pacovalverde/nerdquaxe/case/grill-part2.stl

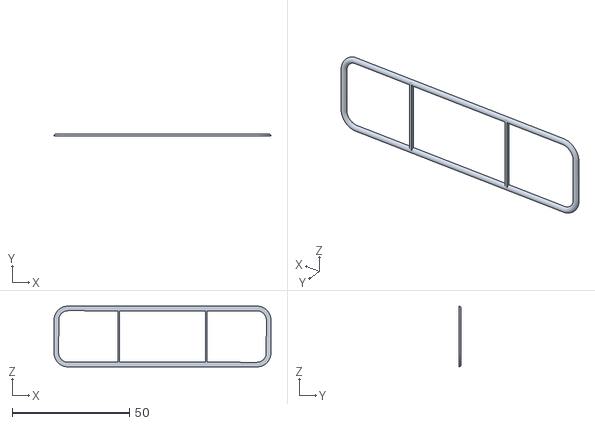
[picture p1: CAD file, 2025-05-31]
case/grill-part2.stl
92.7 x 1.00 x 26.0
