pacovalverde/nerdquaxe/nerdqaxe++/nerdqaxe++/3d/heatsink-13x12x5.step

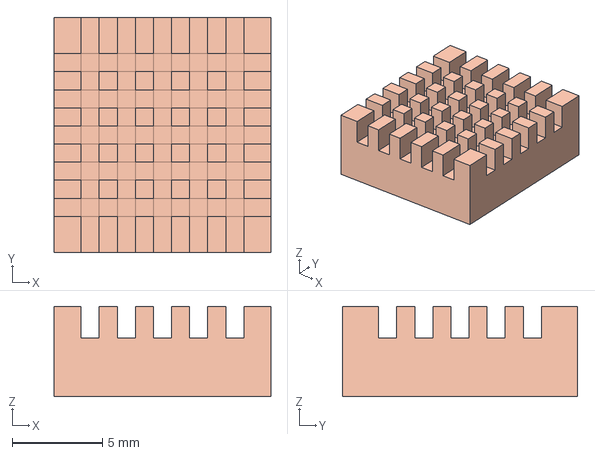
[picture p2: CAD file, 2025-05-31]
nerdqaxe++/nerdqaxe++/3d/heatsink-13x12x5.step
12.0 x 13.0 x 5.00 mm
