pacovalverde/nerdquaxe/nerdqaxe+/nerdqaxe+/3d/bm1366.step

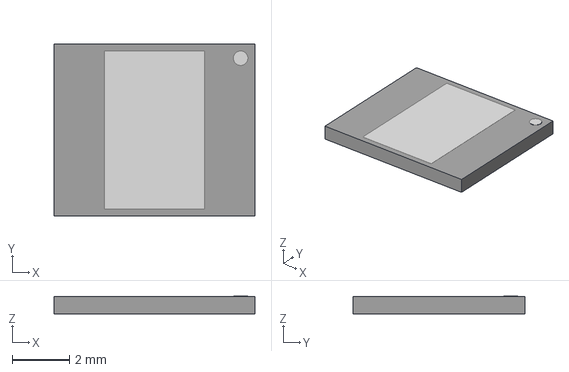
[picture p3: CAD file, 2025-05-31]
nerdqaxe+/nerdqaxe+/3d/bm1366.step
7.00 x 6.00 x 0.61 mm
