pacovalverde/nerdquaxe/case/case.stl

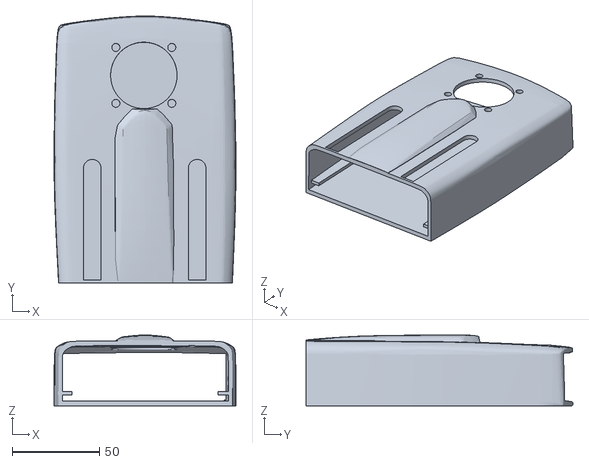
[picture p5: CAD file, 2025-05-31]
case/case.stl
104.1 x 152.7 x 40.6
