pacovalverde/nerdquaxe/qaxe+/qaxe/3d/lga115x.step

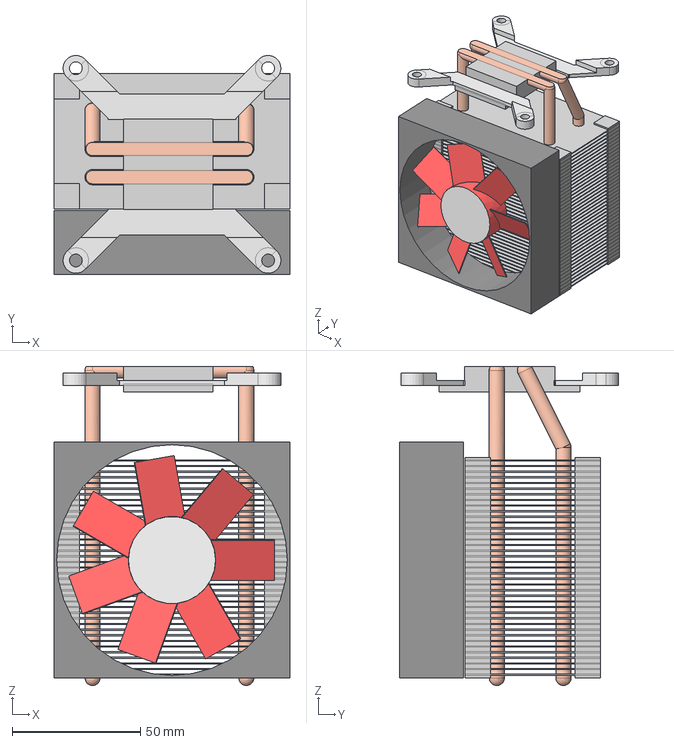
[picture p6: CAD file, 2025-05-31]
qaxe+/qaxe/3d/lga115x.step
92.0 x 85.5 x 124.5 mm
