pacovalverde/nerdquaxe/case/grill-part1.stl

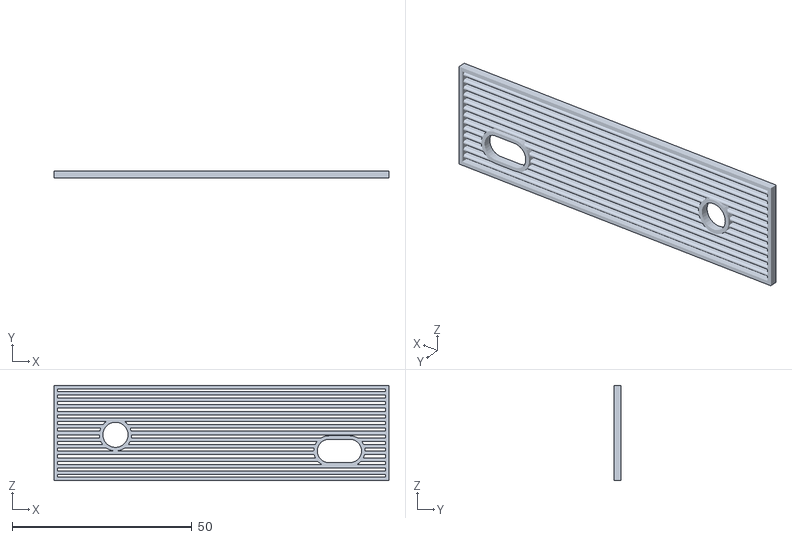
[picture p8: CAD file, 2025-05-31]
case/grill-part1.stl
93.2 x 2.00 x 26.5
