pacovalverde/nerdquaxe/nerdqaxe++/nerdqaxe++/3d/bm1370.step

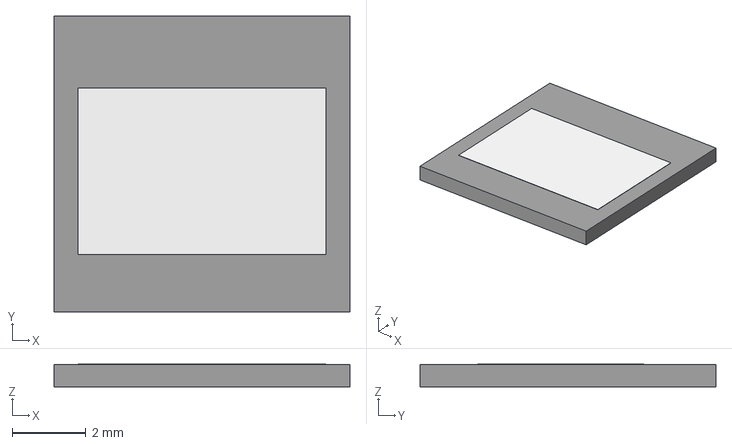
[picture p9: CAD file, 2025-05-31]
nerdqaxe++/nerdqaxe++/3d/bm1370.step
8.00 x 8.00 x 0.61 mm
