pacovalverde/nerdquaxe/qaxe/qaxe/3d/barrel-jack.step

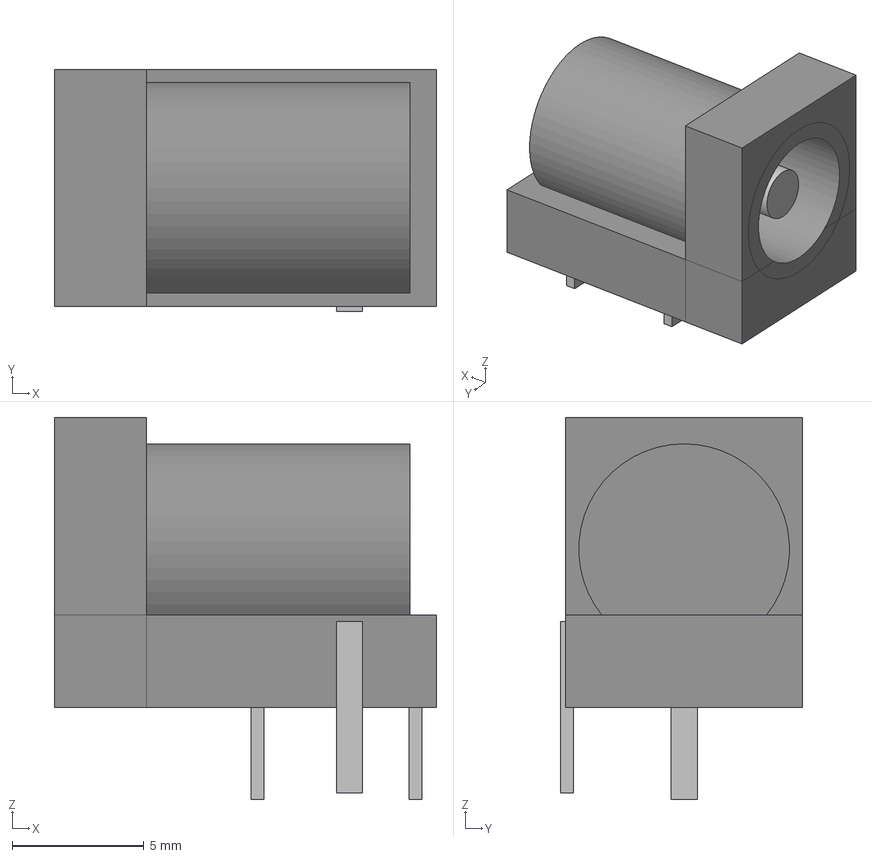
[picture p10: CAD file, 2025-05-31]
qaxe/qaxe/3d/barrel-jack.step
14.5 x 9.20 x 14.5 mm
