pacovalverde/nerdquaxe/case/back.stl

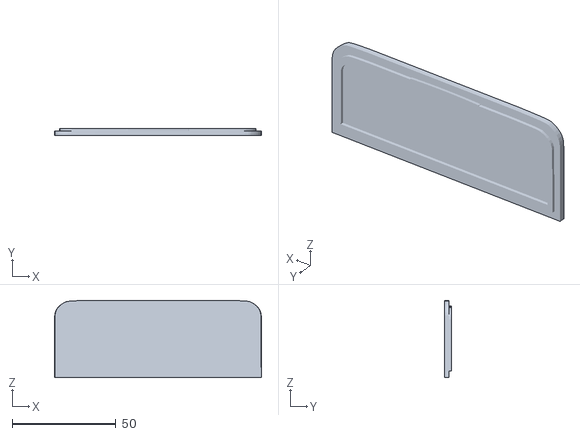
[picture p11: CAD file, 2025-05-31]
case/back.stl
99.7 x 3.54 x 37.3
