pacovalverde/nerdquaxe/nerdqaxe++/nerdqaxe++/3d/DCJ250-20-B-XX-X_REVA1.step

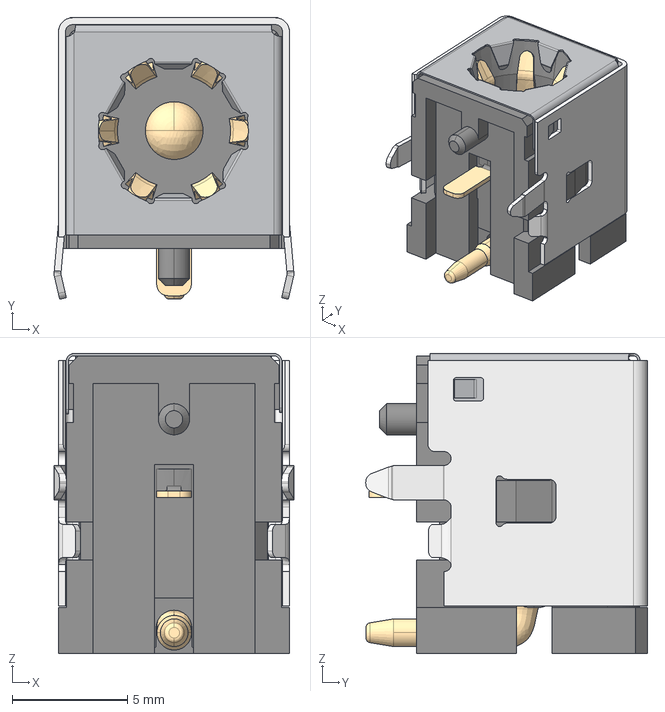
[picture p12: CAD file, 2025-05-31]
nerdqaxe++/nerdqaxe++/3d/DCJ250-20-B-XX-X_REVA1.step
10.4 x 12.2 x 13.0 mm
