pacovalverde/nerdquaxe/nerdqaxe+/nerdqaxe+/3d/KMR231GLFS.stp

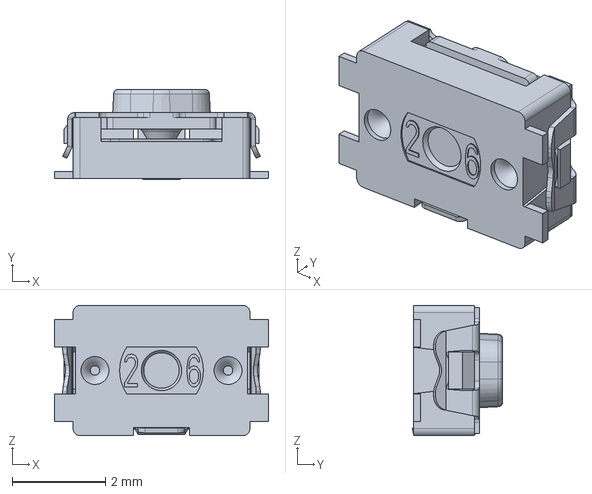
[picture p13: CAD file, 2025-05-31]
nerdqaxe+/nerdqaxe+/3d/KMR231GLFS.stp
4.60 x 1.94 x 2.80 mm
