pacovalverde/nerdquaxe/nerdqaxe+/nerdqaxe+/3d/T-Display-S3.STEP

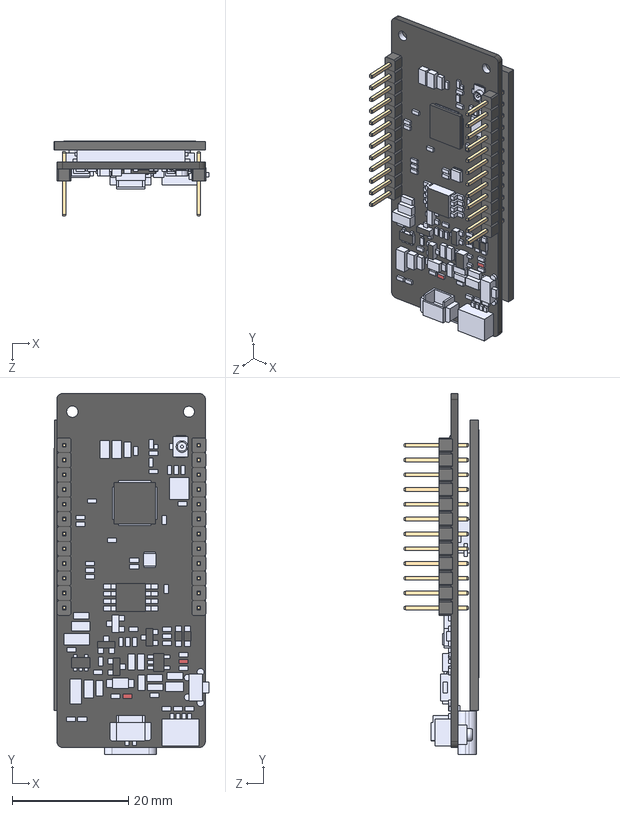
[picture p14: CAD file, 2025-05-31]
nerdqaxe+/nerdqaxe+/3d/T-Display-S3.STEP
26.5 x 62.0 x 12.9 mm
MainBoard_3D
Ecran
1_Male_Pin_2.54_mm x 24
