pacovalverde/nerdquaxe/(list of files, cad)

Other CAD files:
nerdqaxe++/nerdqaxe++/3d/bm1370.scad
nerdqaxe++/nerdqaxe++/3d/csd95472.scad
nerdqaxe++/nerdqaxe++/3d/csg95472.step
