pacovalverde/nerdquaxe/qaxe/qaxe/qaxe.kicad_pcb

## KiCad design qaxe/qaxe/qaxe.kicad_pcb (2025-05-31)

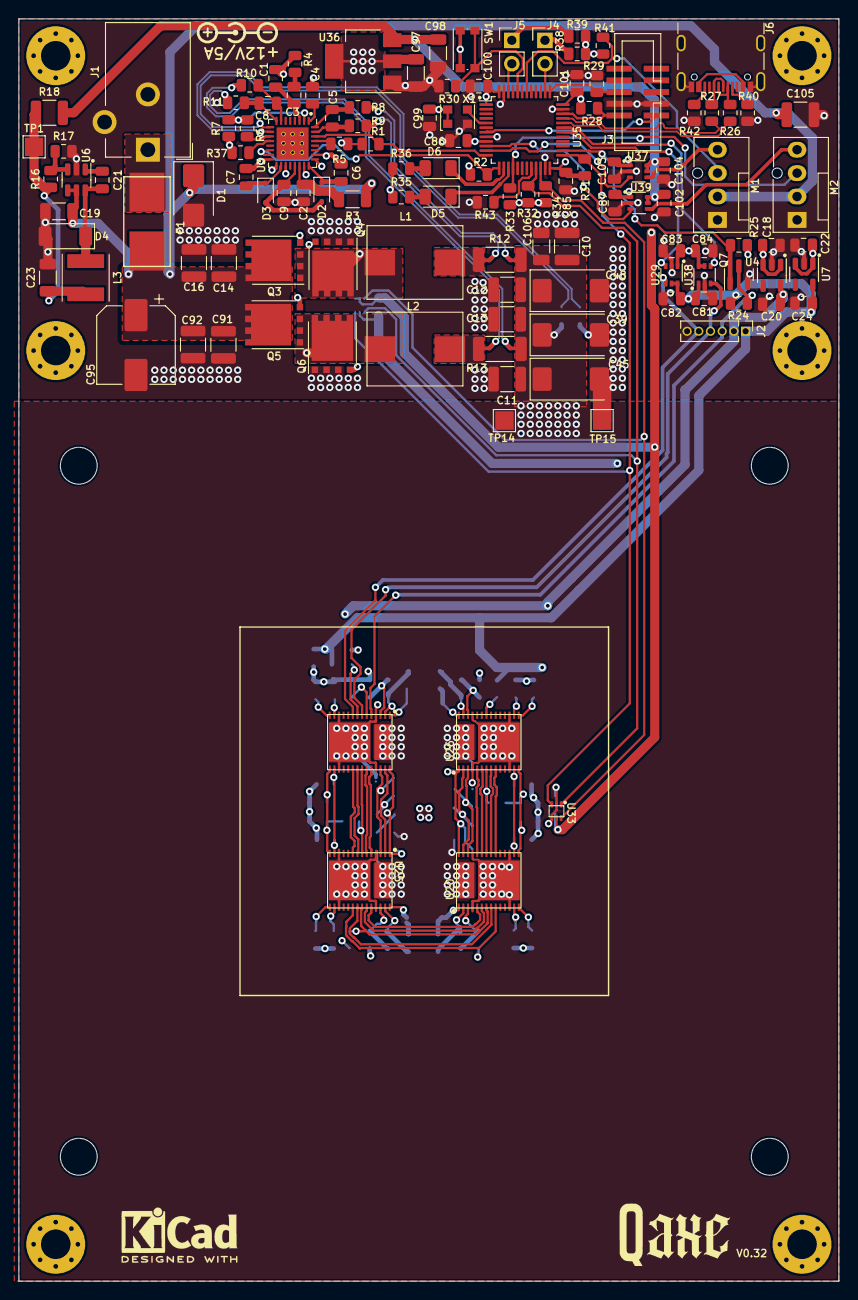
[picture p15: board qaxe.kicad_pcb from above]

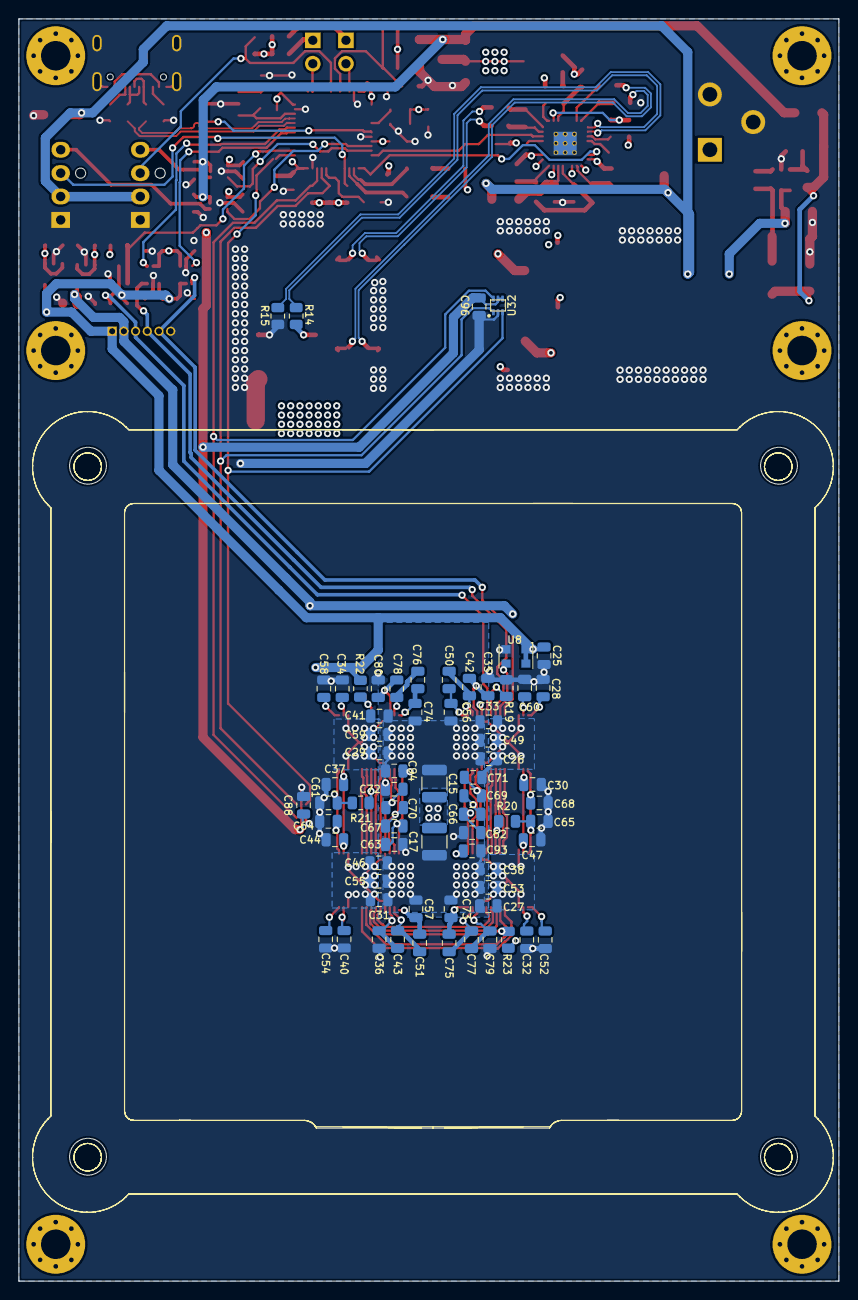
[picture p16: board qaxe.kicad_pcb from below]

Board: 4 copper layers, 89.0 x 137.0 mm, 198 parts (68 on the bottom side), 115 nets.

Parts:
C1: 47p; C_0805_2012Metric
C2, C4, C6, C7, C18, C22, C25, C49, C53, C55, C59, C81, C82, C83, C84, C85, C86, C87, C88, C96, C99, C100, C101, C102, C103, C104: 100n; C_0805_2012Metric
C3: 3.3n; C_0805_2012Metric
C5, C8: 1n; C_0805_2012Metric
C9: 4.7µ/25V; C_0805_2012Metric
C10, C11, C12, C13, C15, C17: 100µ/6.3V; C_1210_3225Metric
C14, C16, C91, C92, C105: 22µ/25V; C_1210_3225Metric
C19, C98: 10µF/50V; C_1206_3216Metric
C20, C24, C28, C30, C32, C33, C34, C35, C36, C37, C38, C40, C41, C42, C43, C44, C46, C47, C50, C51, C52, C54, C56, C57, C58, C60, C61, C62, C63, C64, C65, C66, C67, C68, C69, C70, C71, C72, C73, C74, C75, C76, C77, C78, C79, C80, C93, C94: 1µ; C_0805_2012Metric
C21: 10n/250V; C_0805_2012Metric
C23, C97: 22µ/16V; C_1206_3216Metric
C26, C27, C29, C31: 10µ/16V; C_0805_2012Metric
C39, C45, C48: 330µ/6.3V; CP_EIA-7343-15_Kemet-W
C95: 220µ/25V; CP_Elec_8x10
C106: 4.7µ/6.3V; C_1206_3216Metric
D1: SMBJ12A; D_SMB
D2, D3: CMDSH-3; D_SOD-323
D4: PMEG4030EP,115; D_SOD-128
D5, D6: LED; LED_1206_3216Metric
F1: 5A; fuseholder_littlefuse_blok
J1: Barrel_Jack_Switch; BarrelJack_CUI_PJ-102AH_Horizontal
J2: Conn_01x06; PinHeader_1x06_P1.27mm_Vertical
J3: SWD; PinHeader_IDC_2x05_P1.27mm_Vertical_SMD
J4, J5: Conn_01x02; PinHeader_1x02_P2.54mm_Vertical
J6: USB_C_Receptacle_USB2.0; USB_C_Receptacle_GCT_USB4105-xx-A_16P_TopMnt_Horizontal
L1, L2: 220nH; IFLR-4031GC-01-8x10
L3: 4.7µH/2A/3A; L_Taiyo-Yuden_NR-50xx
M1, M2: Fan_4pin; FanPinHeader_1x04_P2.54mm_Vertical
NT1, NT2, NT3, NT4: NetTie_2; NetTie-2_SMD_Pad0.5mm
NT7: NetTie_2; NetTie-2_L3_SMD_Pad0.5mm
Q3, Q4, Q5, Q6: CSD16415Q5T; VSONP-8-1EP_5x6_P1.27mm
Q7: BSS138; SOT-23
R1, R19, R20, R21, R22, R23, R24, R25, R28, R29, R31, R43: 10k; R_0805_2012Metric
R2, R32, R34: 1.5k; R_0805_2012Metric
R3: 2.2R; R_1206_3216Metric
R4: 8.45k; R_0805_2012Metric
R5, R30: 100k; R_0805_2012Metric
R6: 22k; R_0805_2012Metric
R7: 20k; R_0805_2012Metric
R8, R9, R10, R11: 200; R_0805_2012Metric
R12, R13: 1mR; R_2010_5025Metric
R14, R15: 10; R_0805_2012Metric
R16: 84.5k; R_0805_2012Metric
R17: 16.3k; R_0805_2012Metric
R18: 0; R_1210_3225Metric
R26, R27: 22; R_0805_2012Metric
R33, R41: 2.7k; R_0805_2012Metric
R35, R36, R38, R39: 560; R_0805_2012Metric
R37: 49.9k; R_0805_2012Metric
R40, R42: 5.1k; R_0805_2012Metric
SW1: boot; SW_Push_1P1T_NO_CK_KMR2
TP1, TP14, TP15: 3V3; TestPoint_Pad_2.0x2.0mm
U1: polarity
U3: LTC3856; QFN-32-1EP_5x5mm_P0.5mm_EP3.45x3.45mm_ThermalVias
U4: MCP1824T-0802E; SOT-23-5
U6: AP3211; SOT-23-6
U7: MCP1824T-1802E; SOT-23-5
U8: 25MHz; Oscillator_SMD_EuroQuartz_XO32-4Pin_3.2x2.5mm
U19, U20, U25, U26: BM1366_mode1; BM1366
U29, U37, U38, U39: TXU0101; SOT-363_SC-70-6
U32, U33: TMP1075; TMP1075-DRL
U35: STM32L072CBT6; LQFP-48_7x7mm_P0.5mm
U36: 1117-3.3; SOT-223-3_TabPin2
X1: 8MHz; Oscillator_SMD_EuroQuartz_XO32-4Pin_3.2x2.5mm

Connections:
+0V8: C20.1, C28.2, C30.2, C32.2, C34.2, C37.2, C40.2, C44.2, C47.2, J2.2, U4.5 (VOUT), U19.13 (VDDIO_08_0), U19.16 (VDDIO_08_1), U20.13 (VDDIO_08_0), U20.16 (VDDIO_08_1), U25.13 (VDDIO_08_0), U25.16 (VDDIO_08_1), U26.13 (VDDIO_08_0), U26.16 (VDDIO_08_1)
+1V2: C10.1, C11.1, C12.1, C13.1, C15.1, C17.1, C26.1, C27.1, C29.1, C31.1, C33.1, C38.1, C39.1, C41.1, C45.1, C46.1, C48.1, C49.1, C53.1, C55.1, C56.2, C57.2, C59.1, C62.1, C63.1, C73.1, C74.1, C93.2, C94.2, C106.1, NT3.1, NT4.2, R12.2, R13.2, R14.1, TP14.1, U19.29 (VDD), U20.29 (VDD), U25.29 (VDD), U26.29 (VDD)
+1V8: C24.1, C25.1, C52.1, C54.1, C58.1, C60.1, C61.1, C64.1, C65.1, C68.1, C81.1, C82.1, J2.1, R20.2, R21.2, R22.2, R23.2, R24.2, U7.5 (VOUT), U8.1 (Standby), U8.4 (VDD), U19.14 (VDDIO_18_0), U19.15 (VDDIO_18_1), U20.14 (VDDIO_18_0), U20.15 (VDDIO_18_1), U25.14 (VDDIO_18_0), U25.15 (VDDIO_18_1), U26.14 (VDDIO_18_0), U26.15 (VDDIO_18_1), U29.5 (OE), U29.6 (VCCB), U38.1 (VCCA)
+3V3: C18.1, C22.1, C83.1, C84.1, C85.1, C86.1, C87.1, C88.1, C96.1, C97.1, C99.1, C100.1, C101.1, C103.1, R2.1, R25.2, R28.2, R31.1, R32.1, R33.1, R34.1, R35.1, R36.1, R38.1, R39.1, R41.1, SW1.2, U4.1 (VIN), U4.3 (EN), U7.1 (VIN), U7.3 (EN), U29.1 (VCCA), U32.4 (A0), U32.5 (V+), U33.5 (V+), U35.1 (VLCD), U35.9 (VDDA), U35.24 (VDD), U35.36 (VDD), U35.48 (VDD), U36.2 (VO), U37.1 (VCCA), U38.5 (OE), U38.6 (VCCB), U39.1 (VCCA), X1.1 (EN), X1.4 (V+)
+5V: C98.1, C102.1, C104.1, R18.2, U36.3 (VI), U37.5 (OE), U37.6 (VCCB), U39.5 (OE), U39.6 (VCCB)
+12V: C14.1, C16.1, C19.1, C91.1, C92.1, C95.1, C105.1, D1.1 (A1), F1.1, M1.2 (+), M2.2 (+), Q3.3 (D), Q5.3 (D), R3.1, U6.4 (EN), U6.5 (IN)
/BM1366/BI: R19.2, U19.6 (BI)
/BM1366/CI: J2.5, U19.9 (CI), U29.4 (BY)
/BM1366/CLKI: U8.3 (Out), U19.8 (CLKI)
/BM1366/RESET: Q7.1 (G), R25.1, U35.26 (PB13)
/BM1366/RO: J2.4, U19.7 (RO), U38.3 (A)
/BM1366/RST_N: J2.3, Q7.3 (D), R24.1, U19.5 (NRSTI)
/BM1366/RXD: U35.31 (PA10), U38.4 (BY)
/BM1366/TXD: U29.3 (A), U35.30 (PA9)
/Power/1V2_PGOOD: R2.2, U3.15 (PGOOD), U35.13 (PA3)
/Power/1V2_RUN: R1.2, U3.30 (RUN), U35.12 (PA2)
/Power/DIFF+: R14.2, U3.9 (DIFFP)
/Power/DIFF-: R15.2, U3.10 (DIFFN)
/Power/SENSE1+: NT1.2, R9.1
/Power/SENSE1-: NT3.2, R8.2
/Power/SENSE2+: NT2.1, R10.2
/Power/SENSE2-: NT4.1, R11.2
/STM32/ALERT2: R31.2, U32.3 (ALERT), U33.3 (ALERT), U35.25 (PB12)
/STM32/LED1: D6.1 (K), U35.14 (PA4)
/STM32/LED2: D5.1 (K), U35.15 (PA5)
/STM32/LED3: J4.2, U35.38 (PA15)
/STM32/LED4: J5.2, U35.46 (PB9)
/STM32/NRST: J3.1, U35.7 (NRST)
/STM32/PWM1: U35.10 (PA0), U39.3 (A)
/STM32/PWM2: U35.11 (PA1), U37.3 (A)
/STM32/SCL2: R32.2, U32.1 (SCL), U33.1 (SCL), U35.21 (PB10)
/STM32/SDA2: R34.2, U32.6 (SDA), U33.6 (SDA), U35.22 (PB11)
/STM32/SWCLK: J3.6, R29.2, U35.37 (PA14)
/STM32/SWDIO: J3.2, R28.1, U35.34 (PA13)
/STM32/TACHO1: M2.3 (Tacho), R33.2, U35.16 (PA6)
/STM32/TACHO2: M1.3 (Tacho), R41.2, U35.42 (PB6)
/STM32/USB_D+: R27.1, U35.33 (PA12)
/STM32/USB_D-: R26.1, U35.32 (PA11)
GND: C2.1, C9.2, C10.2, C11.2, C12.2, C13.2, C14.2, C15.2, C16.2, C17.2, C18.2, C19.2, C20.2, C22.2, C23.2, C24.2, C25.2, C26.2, C27.2, C28.1, C29.2, C30.1, C31.2, C32.1, C33.2, C34.1, C35.1, C36.1, C37.1, C38.2, C39.2, C40.1, C41.2, C44.1, C45.2, C46.2, C47.1, C48.2, C49.2, C52.2, C53.2, C54.2, C55.2, C58.2, C59.2, C60.2, C61.2, C64.2, C65.2, C68.2, C71.2, C72.2, C79.2, C80.2, C81.2, C82.2, C83.2, C84.2, C85.2, C86.2, C87.2, C88.2, C91.2, C92.2, C95.2, C96.2, C97.2, C98.2, C99.2, C100.2, C101.2, C102.2, C103.2, C104.2, C105.2, C106.2, D1.2 (A2), D4.2 (A), J1.2, J1.3, J2.6, J3.3, J3.4, J6.A1 (GND), J6.A12 (GND), J6.B1 (GND), J6.B12 (GND), J6.S1 (SHIELD), M1.1 (-), M2.1 (-), NT7.2, Q4.1 (S), Q6.1 (S), Q7.2 (S), R15.1, R17.2, R19.1, R29.1, R30.1, R40.1, R42.1, R43.1, TP15.1, U3.33 (SGND), U4.2 (GND), U6.2 (GND), U7.2 (GND), U8.2 (GND), U19.4 (VDD4_0), U19.12 (PLL_VSS), U19.17 (VSS), U19.25 (VDD4_0), U19.30 (GND), U20.4 (VDD4_0), U20.12 (PLL_VSS), U20.17 (VSS), U20.25 (VDD4_0), U20.30 (GND), U25.4 (VDD4_0), U25.12 (PLL_VSS), U25.17 (VSS), U25.25 (VDD4_0), U25.30 (GND), U26.4 (VDD4_0), U26.12 (PLL_VSS), U26.17 (VSS), U26.25 (VDD4_0), U26.30 (GND), U29.2 (GND), U32.2 (GND), U33.2 (GND), U33.4 (A0), U35.8 (VSSA), U35.23 (VSS), U35.35 (VSS), U35.47 (VSS), U36.1 (GND), U37.2 (GND), U38.2 (GND), U39.2 (GND), X1.2 (GND)
GNDA: C1.2, C4.2, NT7.1, R1.1, R4.2, R5.1, R7.2, R37.1
unnamed: C3.2, R4.1
unnamed: C23.1, L3.2, R16.1, R18.1, TP1.1
unnamed: C9.1, D2.2 (A), D3.2 (A), U3.21 (INTVCC)
unnamed: C6.2, D2.1 (K), U3.24 (BOOST1)
unnamed: C7.1, D3.1 (K), U3.18 (BOOST2)
unnamed: C21.2, D4.1 (K), L3.1, U6.6 (SW)
unnamed: D5.2 (A), R35.2
unnamed: D6.2 (A), R36.2
unnamed: F1.2, J1.1
unnamed: J4.1, R38.2
unnamed: J5.1, R39.2
unnamed: J6.A5 (CC1), R40.2
unnamed: J6.B5 (CC2), R42.2
unnamed: J6.A6 (D+), J6.B6 (D+), R27.2
unnamed: J6.A7 (D-), J6.B7 (D-), R26.2
unnamed: L1.2, NT1.1, R12.1
unnamed: L2.2, NT2.2, R13.1
unnamed: M1.4 (PWM), U37.4 (BY)
unnamed: M2.4 (PWM), U39.4 (BY)
unnamed: Q3.2 (G), U3.25 (TG1)
unnamed: C6.1, L1.1, Q3.1 (S), Q4.3 (D), U3.26 (SW1)
unnamed: Q4.2 (G), U3.23 (BG1)
unnamed: Q5.2 (G), U3.17 (TG2)
unnamed: C7.2, L2.1, Q5.1 (S), Q6.3 (D), U3.16 (SW2)
unnamed: Q6.2 (G), U3.19 (BG2)
unnamed: R6.1, U3.11 (DIFFOUT)
unnamed: R5.2, U3.29 (FREQ)
unnamed: R37.2, U3.12 (ISET)
unnamed: C1.1, C3.1, U3.3 (ITH)
unnamed: C5.2, R9.2, U3.31 (SENSE1+)
unnamed: C5.1, R8.1, U3.32 (SENSE1-)
unnamed: C8.1, R10.1, U3.7 (SENSE2+)
unnamed: C8.2, R11.1, U3.8 (SENSE2-)
unnamed: C4.1, U3.1 (TK/SS)
unnamed: R6.2, R7.1, U3.2 (VFB)
unnamed: C2.2, R3.2, U3.22 (VIN)
unnamed: C21.1, U6.1 (BS)
unnamed: R16.2, R17.1, U6.3 (FB)
unnamed: U19.23 (BO), U25.6 (BI)
unnamed: U19.21 (CLKO), U25.8 (CLKI)
unnamed: U19.20 (CO), U25.9 (CI)
unnamed: U19.24 (NRSTO), U25.5 (NRSTI)
unnamed: R20.1, U19.22 (RI), U25.7 (RO)
unnamed: C50.2, C56.1, U19.1 (VDD1_0)
unnamed: C62.2, C66.1, C93.1, U19.28 (VDD1_1), U25.1 (VDD1_0)
unnamed: C42.2, C50.1, U19.2 (VDD2_0)
unnamed: C66.2, C69.1, U19.27 (VDD2_1), U25.2 (VDD2_0)
unnamed: C35.2, C42.1, U19.3 (VDD3_0)
unnamed: C69.2, C71.1, U19.26 (VDD3_1), U25.3 (VDD3_0)
unnamed: U20.6 (BI), U25.23 (BO)
unnamed: U20.23 (BO), U26.6 (BI)
unnamed: U20.9 (CI), U25.20 (CO)
unnamed: U20.8 (CLKI), U25.21 (CLKO)
unnamed: U20.21 (CLKO), U26.8 (CLKI)
unnamed: U20.20 (CO), U26.9 (CI)
unnamed: U20.5 (NRSTI), U25.24 (NRSTO)
unnamed: U20.24 (NRSTO), U26.5 (NRSTI)
unnamed: R21.1, U20.22 (RI), U26.7 (RO)
unnamed: R23.1, U20.7 (RO), U25.22 (RI)
unnamed: C51.2, C57.1, U20.1 (VDD1_0)
unnamed: C63.2, C67.1, C94.1, U20.28 (VDD1_1), U26.1 (VDD1_0)
unnamed: C43.2, C51.1, U20.2 (VDD2_0)
unnamed: C67.2, C70.1, U20.27 (VDD2_1), U26.2 (VDD2_0)
unnamed: C36.2, C43.1, U20.3 (VDD3_0)
unnamed: C70.2, C72.1, U20.26 (VDD3_1), U26.3 (VDD3_0)
unnamed: C73.2, C75.1, U25.28 (VDD1_1)
unnamed: C75.2, C77.1, U25.27 (VDD2_1)
unnamed: C77.2, C79.1, U25.26 (VDD3_1)
unnamed: R22.1, U26.22 (RI)
unnamed: C74.2, C76.1, U26.28 (VDD1_1)
unnamed: C76.2, C78.1, U26.27 (VDD2_1)
unnamed: C78.2, C80.1, U26.26 (VDD3_1)
unnamed: R30.2, SW1.1, U35.44 (BOOT0)
unnamed: R43.2, U35.20 (PB2)
unnamed: U35.5 (PH0), X1.3 (OUT)
