pacovalverde/nerdquaxe/nerdqaxe+/nerdqaxe+/nerdqaxe+.kicad_pcb

## KiCad design nerdqaxe+/nerdqaxe+/nerdqaxe+.kicad_pcb (2025-05-31)

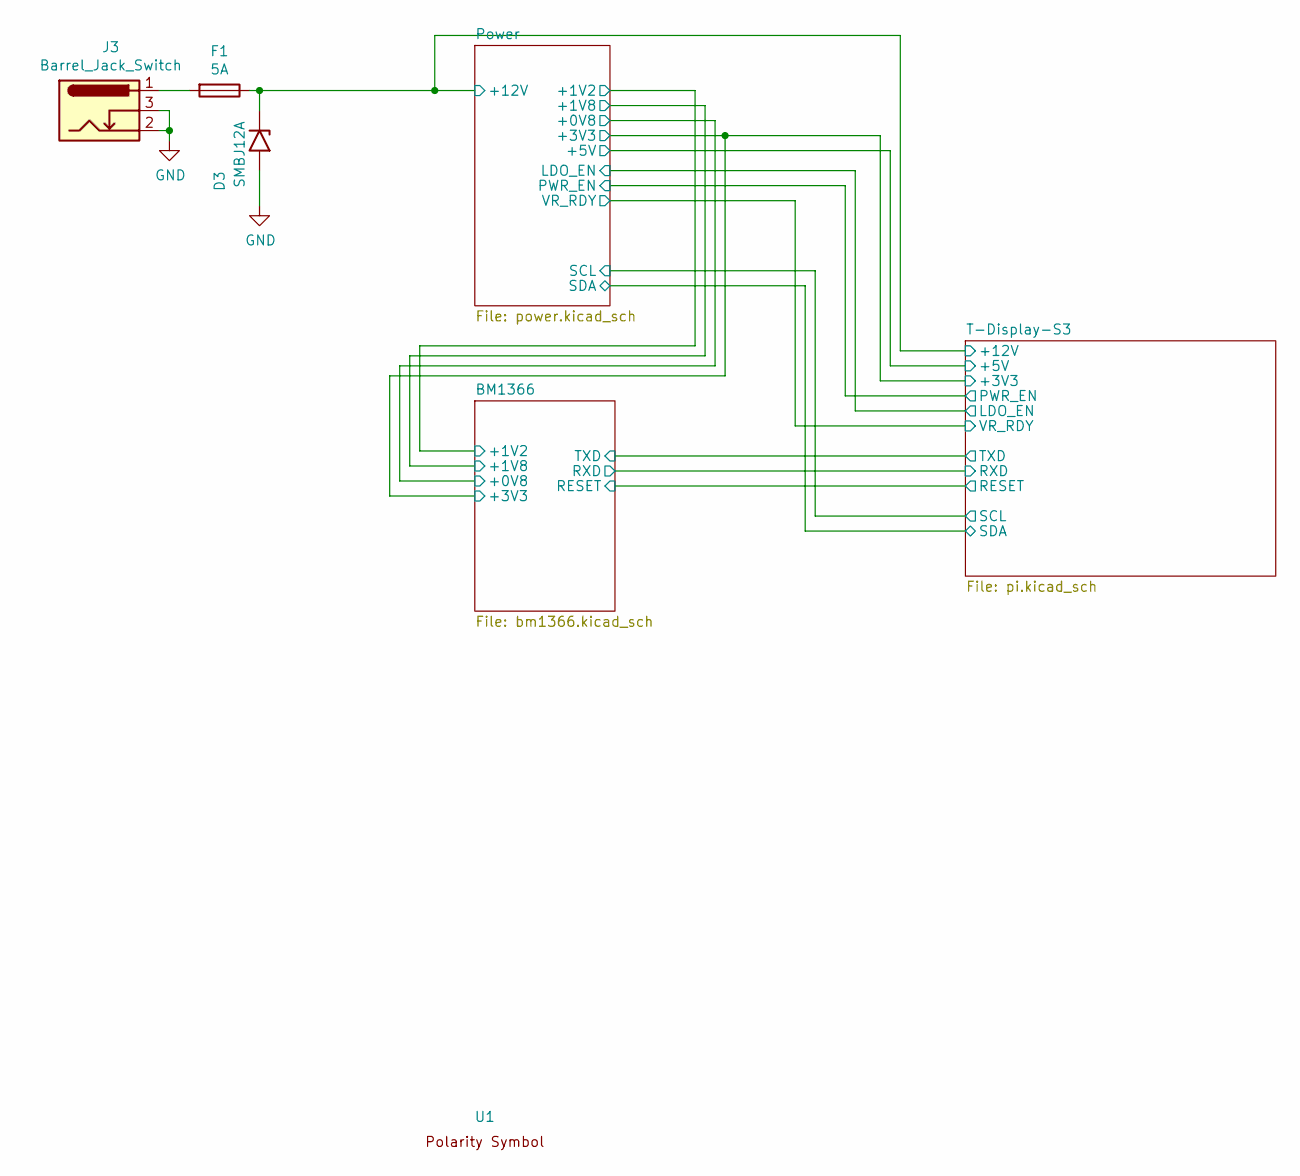
[picture p17: schematic nerdqaxe+.kicad_sch, BM1366 PiAxe]

Parts:
D3: SMBJ12A; D_SMB
F1: 5A; fuseholder_littlefuse_blok
J3: Barrel_Jack_Switch; BarrelJack_CUI_PJ-102AH_Horizontal
U1: polarity

Connections:
unnamed 32: F1.2; also elsewhere on the board

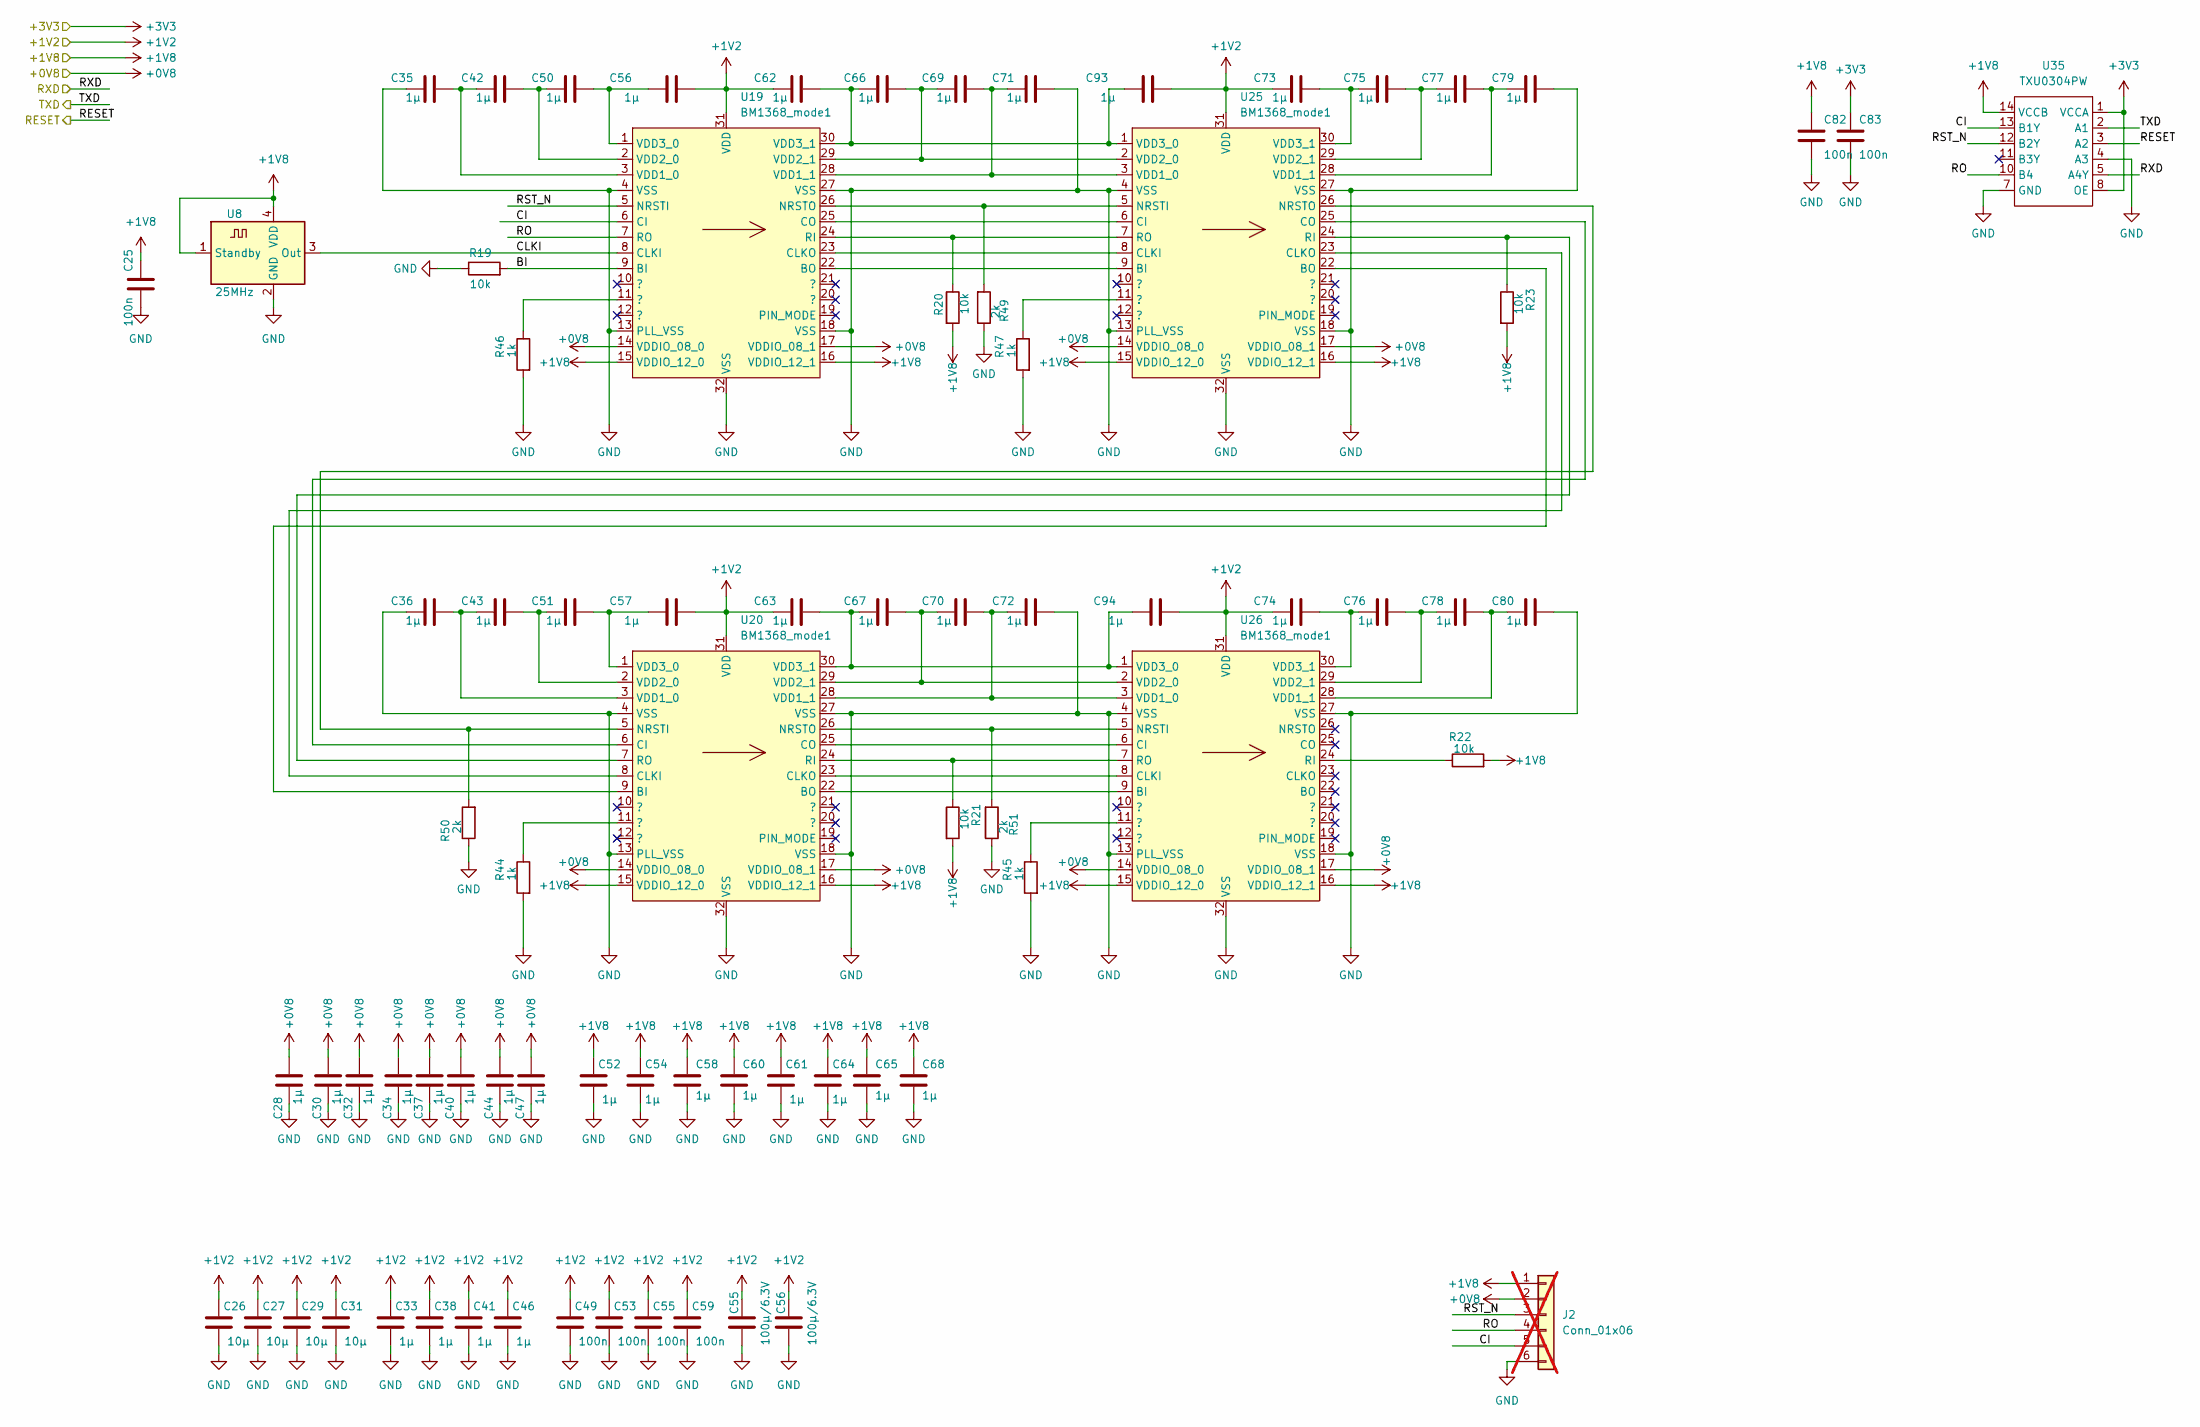
[picture p18: schematic bm1366.kicad_sch, BM1366 PiAxe]

Parts:
C25, C49, C53, C59, C82, C83: 100n; C_0805_2012Metric
C26, C27, C29, C31: 10µ; C_0805_2012Metric
C28, C30, C32, C33, C34, C35, C36, C37, C38, C40, C41, C42, C43, C44, C46, C47, C50, C51, C52, C54, C57, C58, C60, C61, C62, C63, C64, C65, C66, C67, C68, C69, C70, C71, C72, C73, C74, C75, C76, C77, C78, C79, C80, C93, C94: 1µ; C_0805_2012Metric
C55, C56: 100µ/6.3V; C_1210_3225Metric
J2: Conn_01x06; PinHeader_1x06_P1.27mm_Vertical; not fitted
R19, R20, R21, R22, R23: 10k; R_0805_2012Metric
R44, R45, R46, R47: 1k; R_0805_2012Metric
R49, R50, R51: 2k; R_0805_2012Metric
U8: 25MHz; Oscillator_SMD_EuroQuartz_XO32-4Pin_3.2x2.5mm
U19, U20, U25, U26: BM1368_mode1; bm1368-package-modified
U35: TXU0304PW; TSSOP-14_4.4x5mm_P0.65mm

Connections:
+0V8: C28.2, C30.2, C32.2, C34.2, C37.2, C40.2, C44.2, C47.2, J2.2, U19.14 (VDDIO_08_0), U19.17 (VDDIO_08_1), U20.14 (VDDIO_08_0), U20.17 (VDDIO_08_1), U25.14 (VDDIO_08_0), U25.17 (VDDIO_08_1), U26.14 (VDDIO_08_0), U26.17 (VDDIO_08_1); also elsewhere on the board
+1V8: C25.1, C52.1, C54.1, C58.1, C60.1, C61.1, C64.1, C65.1, C68.1, C82.1, J2.1, R20.2, R21.2, R22.2, R23.2, U8.1 (Standby), U8.4 (VDD), U19.15 (VDDIO_12_0), U19.16 (VDDIO_12_1), U20.15 (VDDIO_12_0), U20.16 (VDDIO_12_1), U25.15 (VDDIO_12_0), U25.16 (VDDIO_12_1), U26.15 (VDDIO_12_0), U26.16 (VDDIO_12_1), U35.14 (VCCB); also elsewhere on the board
+3V3: C83.1, U35.1 (VCCA), U35.8 (OE); also elsewhere on the board
/BM1366/BI: R19.2, U19.9 (BI)
/BM1366/CI: J2.5, U19.6 (CI), U35.13 (B1Y)
/BM1366/CLKI: U8.3 (Out), U19.8 (CLKI)
/BM1366/RESET: U35.3 (A2); also elsewhere on the board
/BM1366/RO: J2.4, U19.7 (RO), U35.10 (B4)
/BM1366/RST_N: J2.3, U19.5 (NRSTI), U35.12 (B2Y)
/BM1366/RXD: U35.5 (A4Y); also elsewhere on the board
/BM1366/TXD: U35.2 (A1); also elsewhere on the board
unnamed: R44.1, U20.11 (?)
unnamed: R45.1, U26.11 (?)
unnamed: R46.1, U19.11 (?)
unnamed: R47.1, U25.11 (?)
unnamed: U19.22 (BO), U25.9 (BI)
unnamed: U19.23 (CLKO), U25.8 (CLKI)
unnamed: U19.25 (CO), U25.6 (CI)
unnamed: R49.2, U19.26 (NRSTO), U25.5 (NRSTI)
unnamed: R20.1, U19.24 (RI), U25.7 (RO)
unnamed: C35.2, C42.1, U19.3 (VDD1_0)
unnamed: C69.2, C71.1, U19.28 (VDD1_1), U25.3 (VDD1_0)
unnamed: C42.2, C50.1, U19.2 (VDD2_0)
unnamed: C66.2, C69.1, U19.29 (VDD2_1), U25.2 (VDD2_0)
unnamed: C62.2, C66.1, C93.1, U19.30 (VDD3_1), U25.1 (VDD3_0)
unnamed: U20.9 (BI), U25.22 (BO)
unnamed: U20.22 (BO), U26.9 (BI)
unnamed: U20.6 (CI), U25.25 (CO)
unnamed: U20.8 (CLKI), U25.23 (CLKO)
unnamed: U20.23 (CLKO), U26.8 (CLKI)
unnamed: U20.25 (CO), U26.6 (CI)
unnamed: R50.2, U20.5 (NRSTI), U25.26 (NRSTO)
unnamed: R51.2, U20.26 (NRSTO), U26.5 (NRSTI)
unnamed: R21.1, U20.24 (RI), U26.7 (RO)
unnamed: R23.1, U20.7 (RO), U25.24 (RI)
unnamed: C36.2, C43.1, U20.3 (VDD1_0)
unnamed: C70.2, C72.1, U20.28 (VDD1_1), U26.3 (VDD1_0)
unnamed: C43.2, C51.1, U20.2 (VDD2_0)
unnamed: C67.2, C70.1, U20.29 (VDD2_1), U26.2 (VDD2_0)
unnamed: C51.2, C57.1, U20.1 (VDD3_0)
unnamed: C63.2, C67.1, C94.1, U20.30 (VDD3_1), U26.1 (VDD3_0)
unnamed: C77.2, C79.1, U25.28 (VDD1_1)
unnamed: C75.2, C77.1, U25.29 (VDD2_1)
unnamed: C73.2, C75.1, U25.30 (VDD3_1)
unnamed: R22.1, U26.24 (RI)
unnamed: C78.2, C80.1, U26.28 (VDD1_1)
unnamed: C76.2, C78.1, U26.29 (VDD2_1)
unnamed: C74.2, C76.1, U26.30 (VDD3_1)

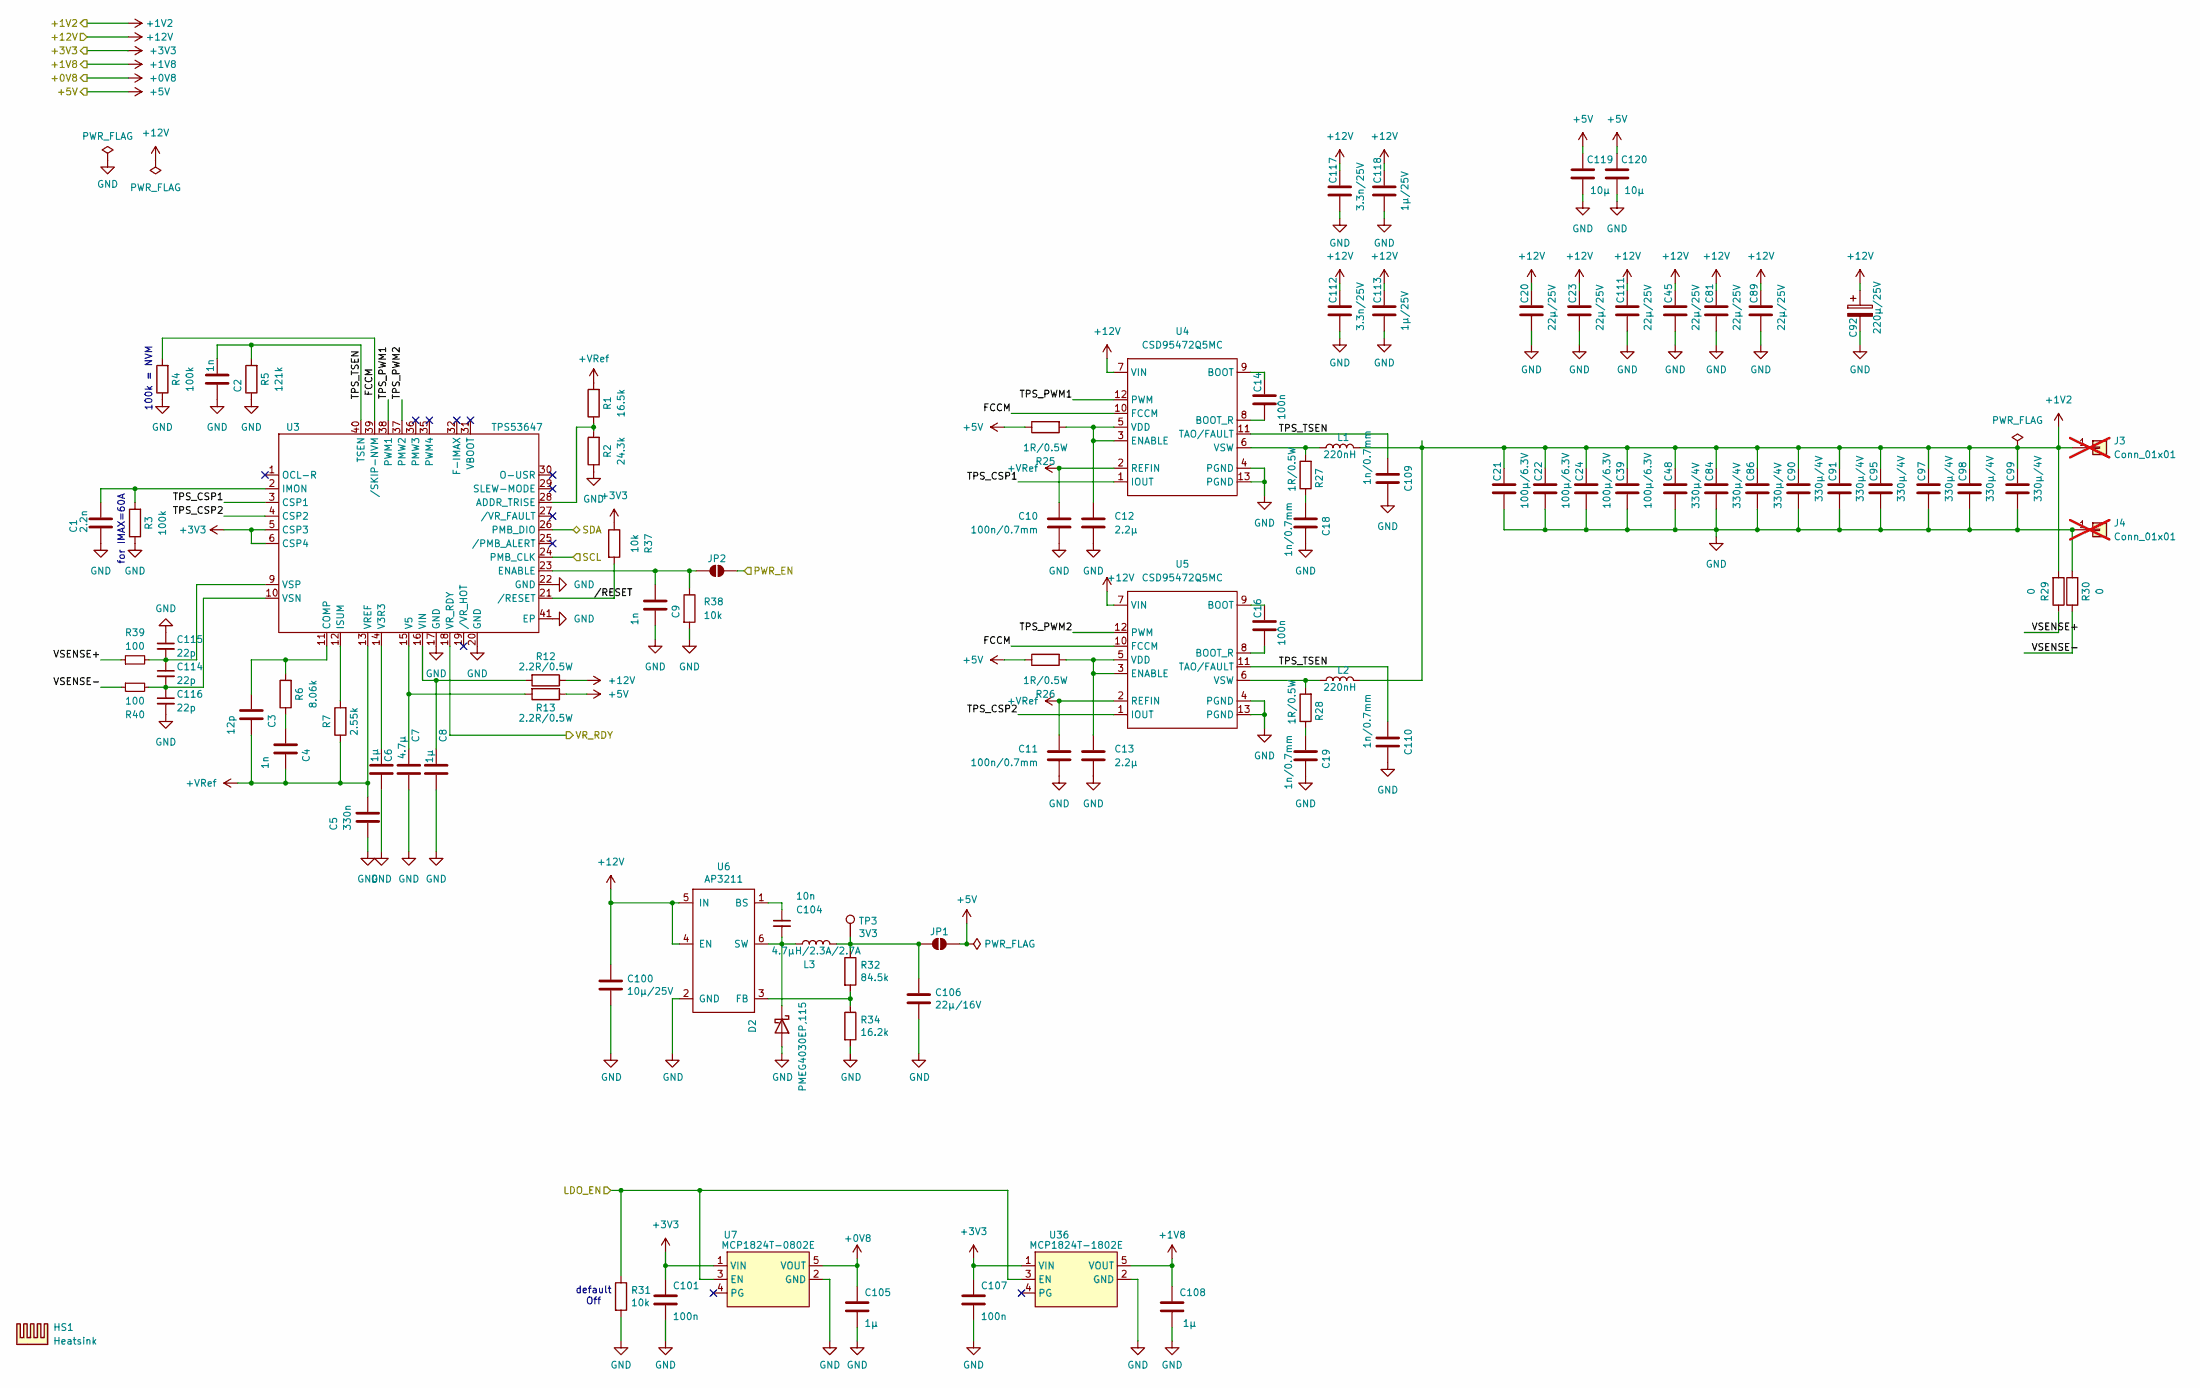
[picture p19: schematic power.kicad_sch, BM1366 bitaxe]

Parts:
C1: 2.2n; C_0805_2012Metric
C2, C4, C9: 1n; C_0805_2012Metric
C3: 12p; C_0603_1608Metric
C5: 330n; C_0805_2012Metric
C6, C8, C105, C108: 1µ; C_0805_2012Metric
C7: 4.7µ; C_0805_2012Metric
C10, C11: 100n/0.7mm; C_0805_2012Metric
C12, C13: 2.2µ; C_0805_2012Metric
C14, C16, C101, C107: 100n; C_0805_2012Metric
C18, C19, C109, C110: 1n/0.7mm; C_0805_2012Metric
C20, C23, C45, C81, C89, C111: 22µ/25V; C_1210_3225Metric
C21, C22, C24, C39: 100µ/6.3V; C_1210_3225Metric
C48, C84, C86, C90, C91, C95, C97, C98, C99: 330µ/4V; C_1210_3225Metric
C92: 220µ/25V; CP_Elec_8x10
C100: 10µ/25V; C_0805_2012Metric
C104: 10n; C_0805_2012Metric
C106: 22µ/16V; C_1206_3216Metric
C112, C117: 3.3n/25V; C_0805_2012Metric
C113, C118: 1µ/25V; C_0805_2012Metric
C114, C115, C116: 22p; C_0603_1608Metric
C119, C120: 10µ; C_0805_2012Metric
D2: PMEG4030EP,115; D_SOD-128
HS1: Heatsink
J3, J4: Conn_01x01; Wuerth_REDCUBE-THR_WP-THRBU_74650194_THR; not fitted
JP1, JP2: SolderJumper_2_Open; SolderJumper-2_P1.3mm_Open_RoundedPad1.0x1.5mm
L1, L2: 220nH; IFLR-4031GC-01-8x10
L3: 4.7µH/2.3A/2.7A; L_Taiyo-Yuden_NR-50xx
R1: 16.5k; R_0805_2012Metric
R2: 24.3k; R_0805_2012Metric
R3, R4: 100k; R_0805_2012Metric
R5: 121k; R_0805_2012Metric
R6: 8.06k; R_0805_2012Metric
R7: 2.55k; R_0805_2012Metric
R12, R13: 2.2R/0.5W; R_0805_2012Metric
R25, R26, R27, R28: 1R/0.5W; R_0805_2012Metric
R29, R30: 0; R_0805_2012Metric
R31, R37, R38: 10k; R_0805_2012Metric
R32: 84.5k; R_0805_2012Metric
R34: 16.2k; R_0805_2012Metric
R39, R40: 100; R_0805_2012Metric
TP3: 3V3; TestPoint_Pad_2.0x2.0mm
U3: TPS53647; Texas_RHA0040B_VQFN-40-1EP_6x6mm_P0.5mm_EP4.15x4.15mm_Therm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
U4, U5: CSD95472Q5MC; CSD95472-SON-5x6
U6: AP3211; SOT-23-6
U7: MCP1824T-0802E; SOT-23-5
U36: MCP1824T-1802E; SOT-23-5

Connections:
+0V8: C105.1, U7.5 (VOUT); also elsewhere on the board
+1V8: C108.1, U36.5 (VOUT); also elsewhere on the board
+3V3: C101.1, C107.1, R37.1, U3.5 (CSP3), U3.6 (CSP4), U7.1 (VIN), U36.1 (VIN); also elsewhere on the board
+VRef: C3.2, C4.2, C5.1, C10.1, C11.1, R1.2, R7.1, U3.13 (VREF), U4.2 (REFIN), U5.2 (REFIN)
/Power/FCCM: R4.2, U3.39 (/SKIP-NVM), U4.10 (FCCM), U5.10 (FCCM)
/Power/LDO_EN: R31.1, U7.3 (EN), U36.3 (EN); also elsewhere on the board
/Power/PWR_EN: JP2.2 (B); also elsewhere on the board
/Power/TPS_CSP1: U3.3 (CSP1), U4.1 (IOUT)
/Power/TPS_CSP2: U3.4 (CSP2), U5.1 (IOUT)
/Power/TPS_PWM1: U3.38 (PWM1), U4.12 (PWM)
/Power/TPS_PWM2: U3.37 (PMW2), U5.12 (PWM)
/Power/TPS_TSEN: C2.1, C109.1, C110.1, R5.2, U3.40 (TSEN), U4.11 (TAO/FAULT), U5.11 (TAO/FAULT)
/Power/VR_RDY: U3.18 (VR_RDY); also elsewhere on the board
/Power/VSENSE+: R29.1, R39.1
/Power/VSENSE-: R30.1, R40.1
/Power//RESET: R37.2, U3.21 (/RESET)
/T-Display-S3/SCL: U3.24 (PMB_CLK); also elsewhere on the board
/T-Display-S3/SDA: U3.26 (PMB_DIO); also elsewhere on the board
unnamed: C4.1, R6.1
unnamed: C18.1, R27.1
unnamed: C19.1, R28.1
unnamed: C104.2, D2.1 (K), L3.1, U6.6 (SW)
unnamed: C106.1, JP1.1 (A), L3.2, R32.1, TP3.1
unnamed: C9.1, JP2.1 (A), R38.1, U3.23 (ENABLE)
unnamed: R1.1, R2.2, U3.28 (ADDR_TRISE)
unnamed: C3.1, R6.2, U3.11 (COMP)
unnamed: C1.1, R3.2, U3.2 (IMON)
unnamed: R7.2, U3.12 (ISUM)
unnamed: C6.1, U3.14 (V3R3)
unnamed: C7.2, R13.2, U3.15 (V5)
unnamed: C8.2, R12.2, U3.16 (VIN)
unnamed: C114.2, C116.1, R40.2, U3.10 (VSN)
unnamed: C114.1, C115.2, R39.2, U3.9 (VSP)
unnamed: C14.1, U4.9 (BOOT)
unnamed: C14.2, U4.8 (BOOT_R)
unnamed: C12.1, R25.2, U4.3 (ENABLE), U4.5 (VDD)
unnamed: L1.1, R27.2, U4.6 (VSW)
unnamed: C16.1, U5.9 (BOOT)
unnamed: C16.2, U5.8 (BOOT_R)
unnamed: C13.1, R26.2, U5.3 (ENABLE), U5.5 (VDD)
unnamed: L2.1, R28.2, U5.6 (VSW)
unnamed: C104.1, U6.1 (BS)
unnamed: R32.2, R34.1, U6.3 (FB)

Notes on the sheet:
default Off
for IMAX=60A
100k = NVM
