pacovalverde/nerdquaxe/nerdqaxe+/nerdqaxe+/nerdqaxe+.kicad_pcb

## KiCad design nerdqaxe+/nerdqaxe+/nerdqaxe+.kicad_pcb (continued)

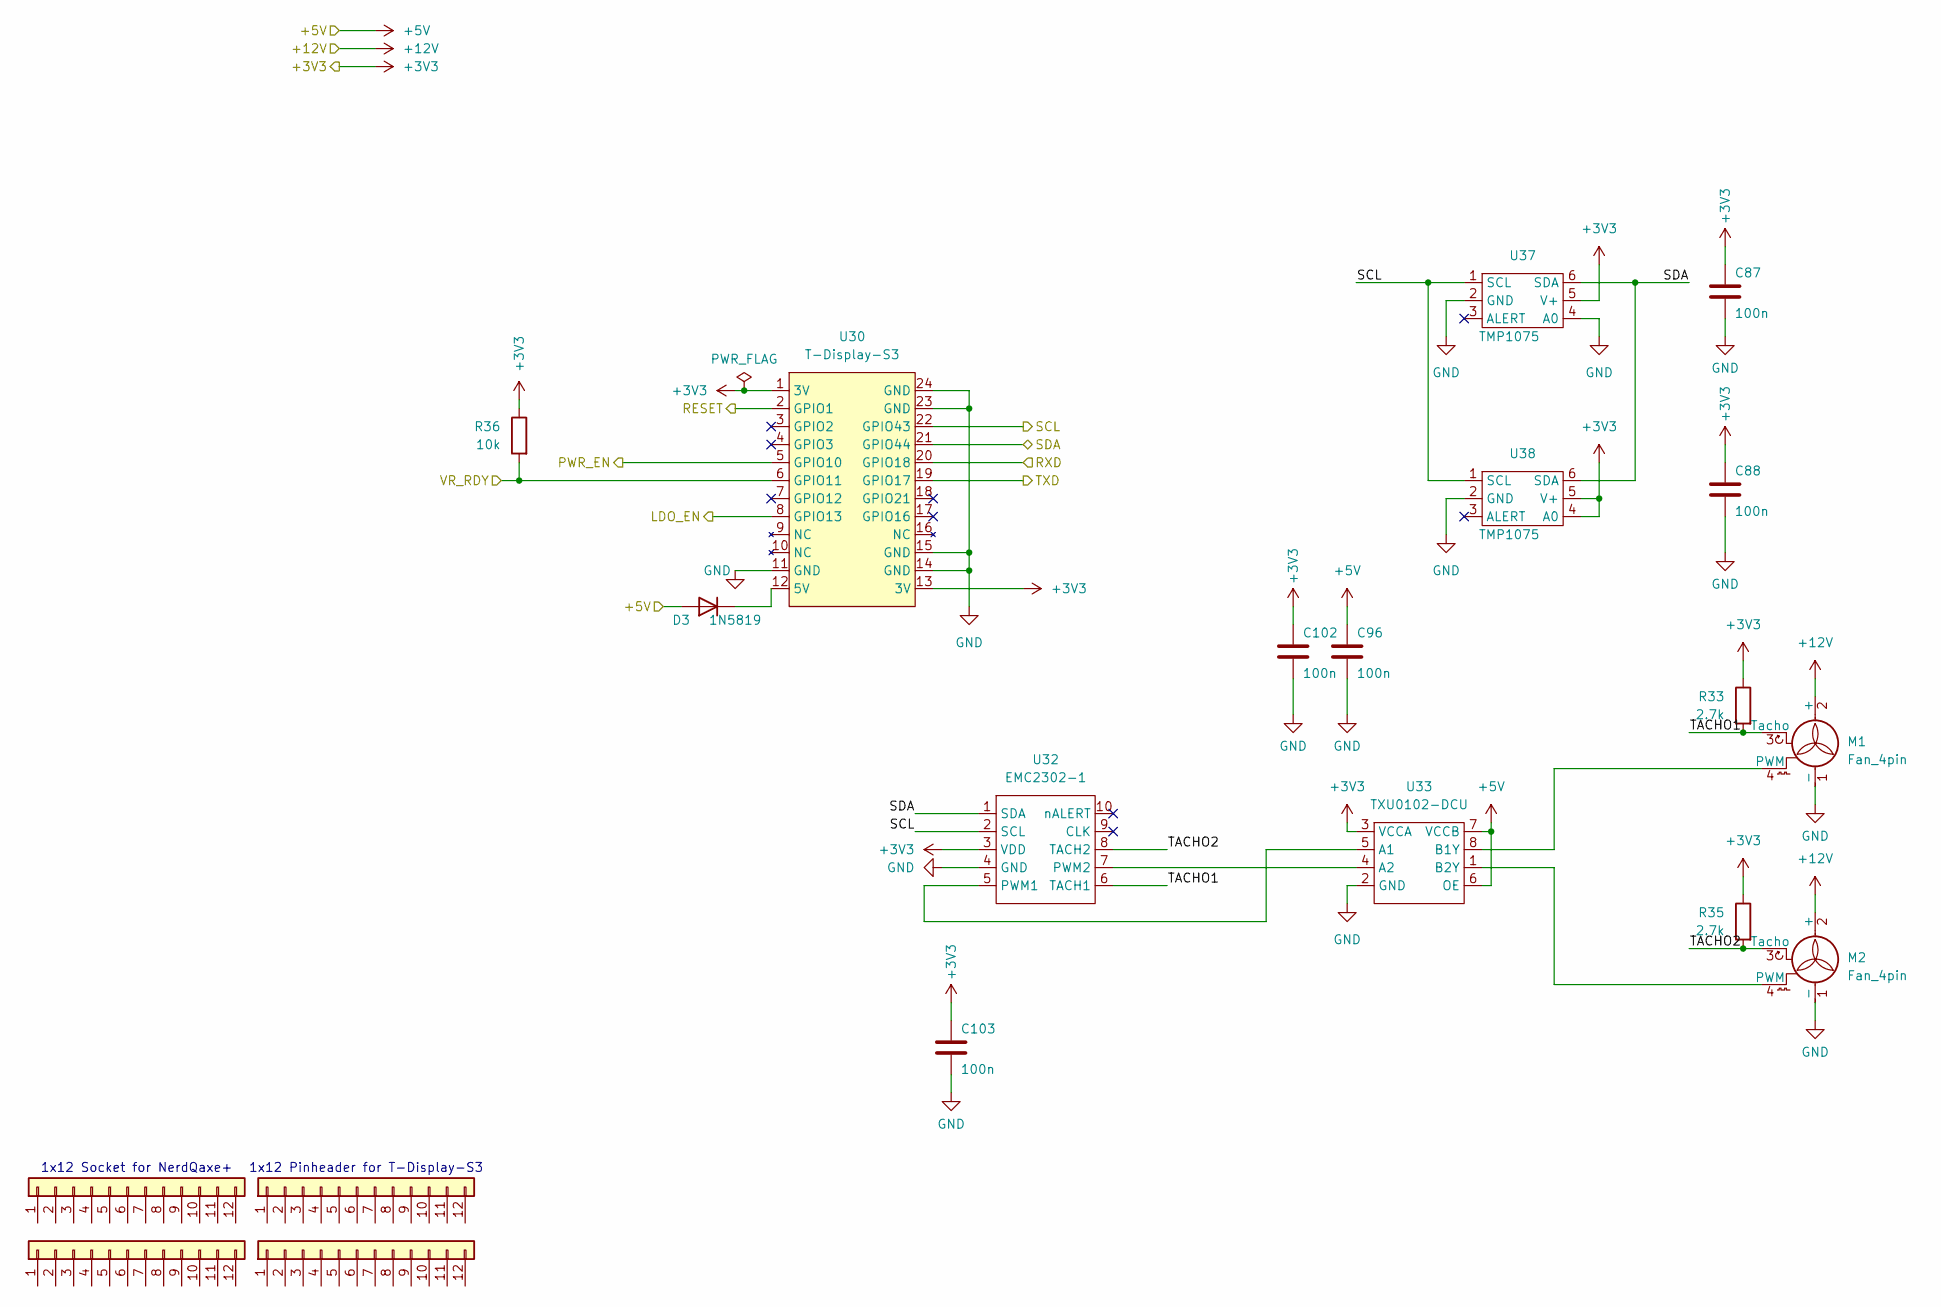
[picture p20: schematic pi.kicad_sch]

Parts:
C87, C88, C96, C102, C103: 100n; C_0805_2012Metric
D3: 1N5819; D_SOD-123
J5, J6: Conn_01x12-Socket
J7, J8: Conn_01x12-Header
M1, M2: Fan_4pin; FanPinHeader_1x04_P2.54mm_Vertical
R33, R35: 2.7k; R_0805_2012Metric
R36: 10k; R_0805_2012Metric
U30: T-Display-S3
U32: EMC2302-1; MSOP-10_3x3mm_P0.5mm
U33: TXU0102-DCU; VSSOP-8_2.3x2mm_P0.5mm
U37, U38: TMP1075; TMP1075-DRL

Connections:
+3V3: C87.1, C88.1, C102.1, C103.1, R33.1, R35.1, R36.1, U30.1 (3V), U30.13 (3V), U32.3 (VDD), U33.3 (VCCA), U37.5 (V+), U38.4 (A0), U38.5 (V+); also elsewhere on the board
/BM1366/RESET: U30.2 (GPIO1); also elsewhere on the board
/BM1366/RXD: U30.20 (GPIO18); also elsewhere on the board
/BM1366/TXD: U30.19 (GPIO17); also elsewhere on the board
/Power/LDO_EN: U30.8 (GPIO13); also elsewhere on the board
/Power/PWR_EN: U30.5 (GPIO10); also elsewhere on the board
/Power/VR_RDY: R36.2, U30.6 (GPIO11); also elsewhere on the board
/T-Display-S3/SCL: U30.22 (GPIO43), U32.2 (SCL), U37.1 (SCL), U38.1 (SCL); also elsewhere on the board
/T-Display-S3/SDA: U30.21 (GPIO44), U32.1 (SDA), U37.6 (SDA), U38.6 (SDA); also elsewhere on the board
/T-Display-S3/TACHO1: M1.3 (Tacho), R33.2, U32.6 (TACH1)
/T-Display-S3/TACHO2: M2.3 (Tacho), R35.2, U32.8 (TACH2)
unnamed: M1.4 (PWM), U33.8 (B1Y)
unnamed: M2.4 (PWM), U33.1 (B2Y)
unnamed: U32.5 (PWM1), U33.5 (A1)
unnamed: U32.7 (PWM2), U33.4 (A2)

Notes on the sheet:
1x12 Socket for NerdQaxe+
1x12 Pinheader for T-Display-S3

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
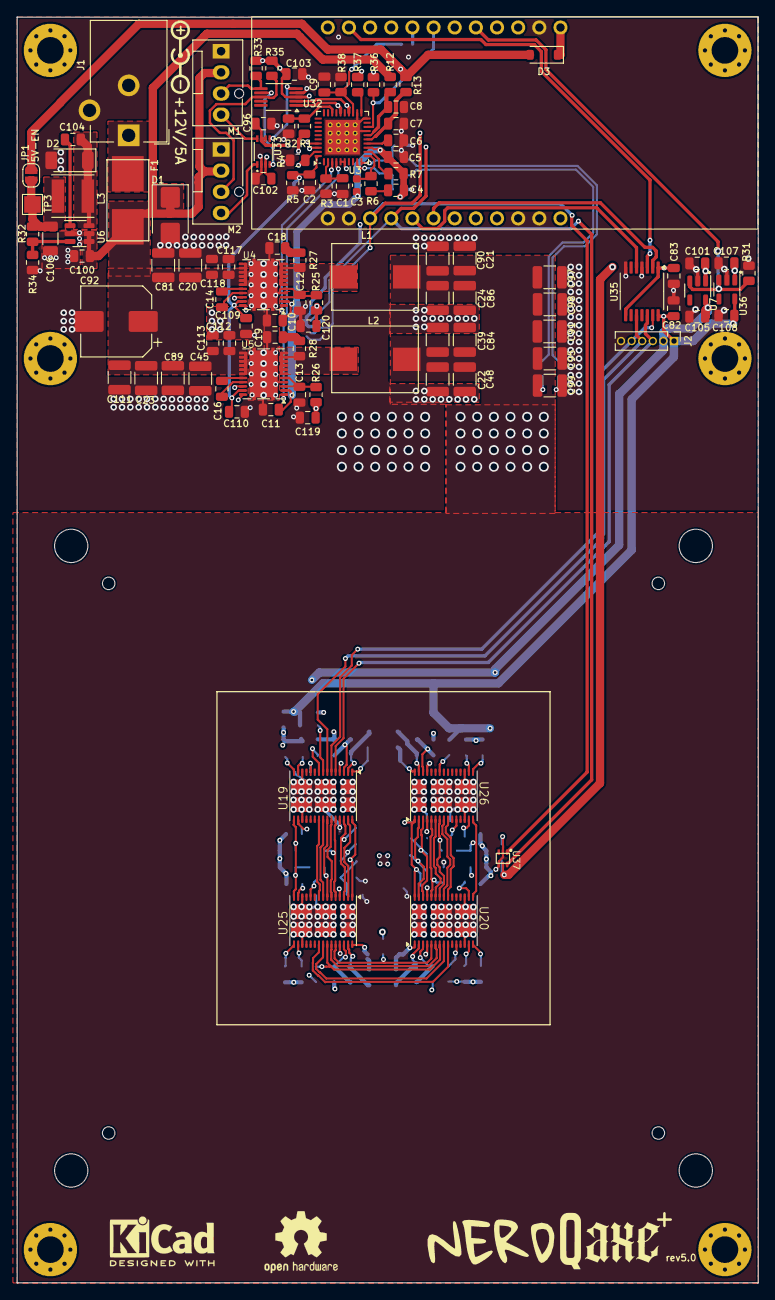
[picture p21: board nerdqaxe+.kicad_pcb from above]

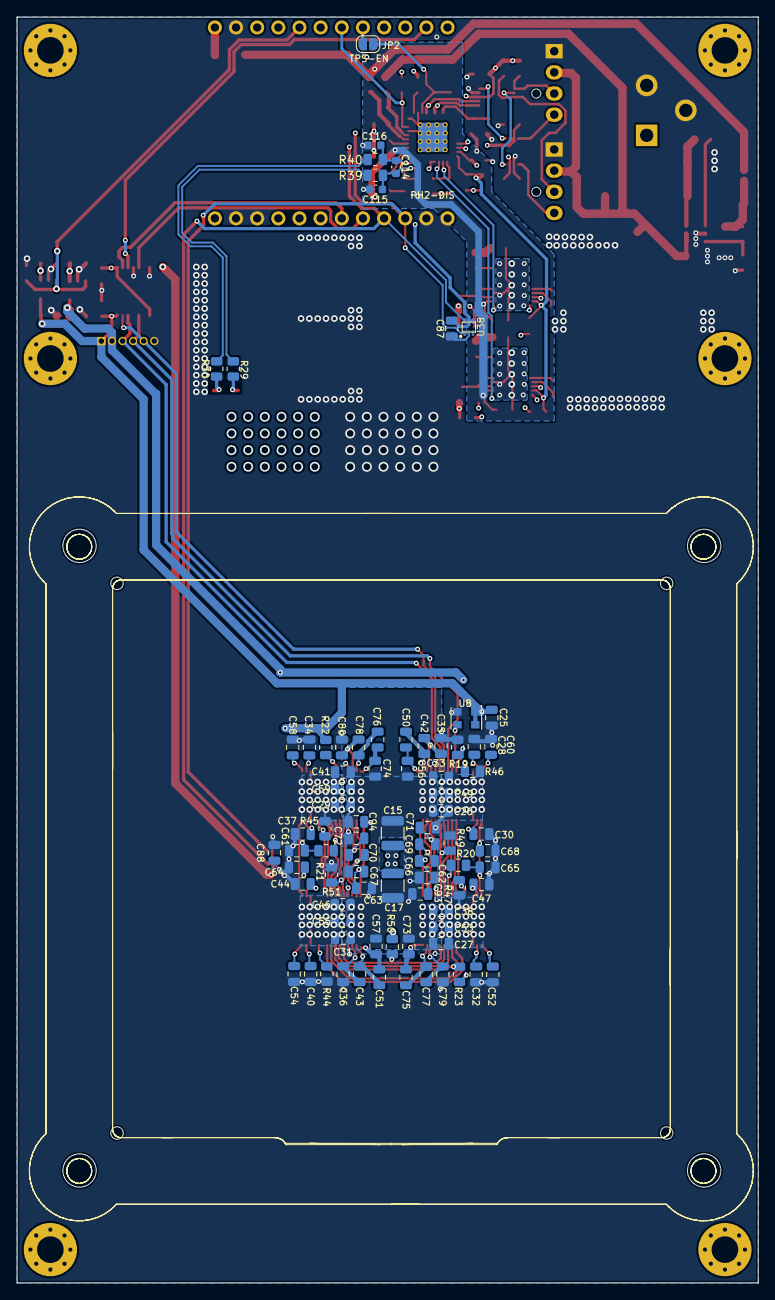
[picture p22: board nerdqaxe+.kicad_pcb from below]

Board: 4 copper layers, 89.0 x 152.0 mm, 188 parts (81 on the bottom side), 101 nets.

Other parts of the board:
C15, C17: 100µ/6.3V; C_1210_3225Metric
D1: SMBJ12A; D_SMB
J1: Barrel_Jack_Switch; BarrelJack_CUI_PJ-102AH_Horizontal

Their connections:
unnamed 32: J1.1; also elsewhere on the board
