pacovalverde/nerdquaxe/nerdqaxe++/nerdqaxe++/power-stage.kicad_sch

## KiCad design nerdqaxe++/nerdqaxe++/power-stage.kicad_sch (2025-05-31)

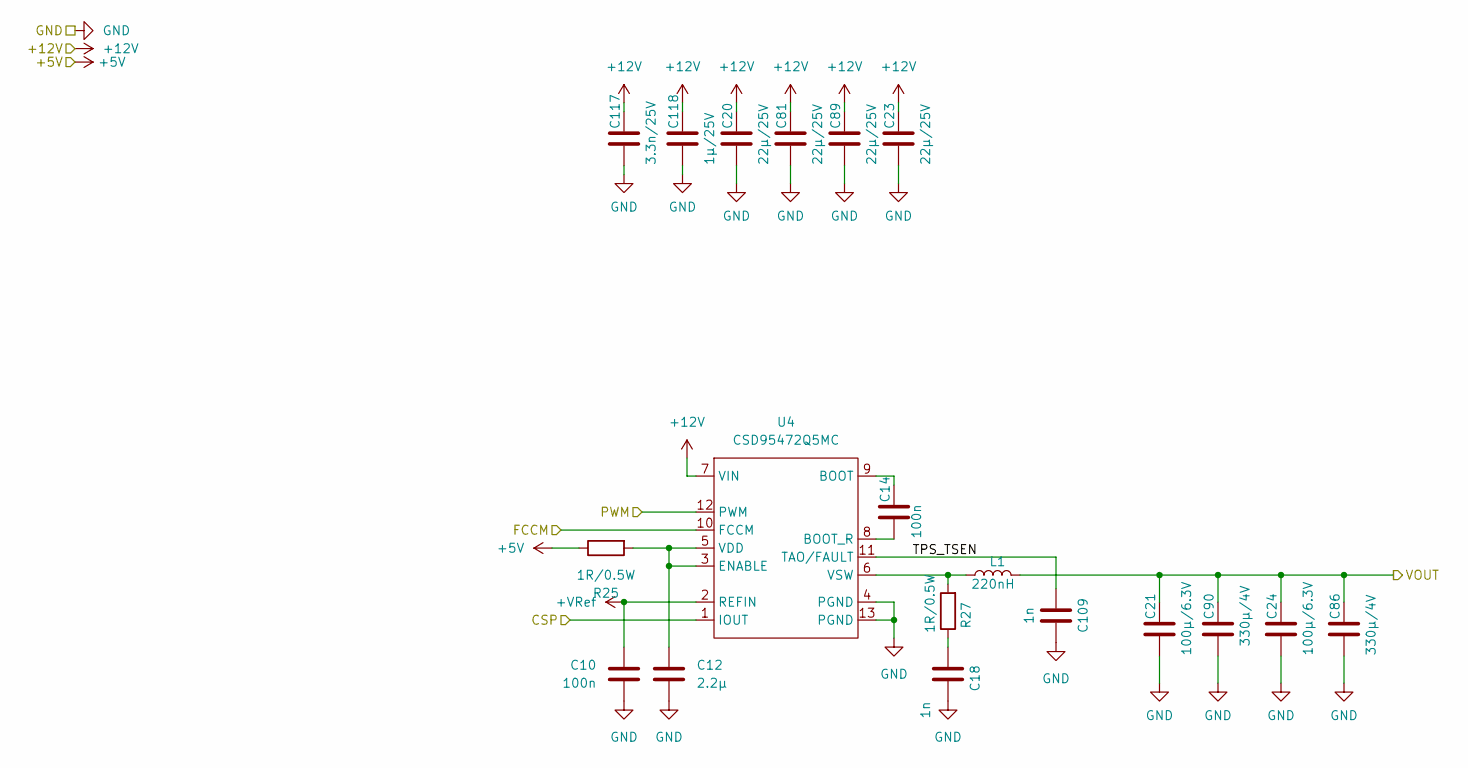
[picture p25: schematic power-stage.kicad_sch]

Parts:
C10, C14: 100n; C_0805_2012Metric
C12: 2.2µ; C_0805_2012Metric
C18, C109: 1n; C_0805_2012Metric
C20, C23, C81, C89: 22µ/25V; C_1210_3225Metric
C21, C24: 100µ/6.3V; C_1210_3225Metric
C86, C90: 330µ/4V; C_1210_3225Metric
C117: 3.3n/25V; C_0805_2012Metric
C118: 1µ/25V; C_0805_2012Metric
L1: 220nH; IFLR-4031GC-01-8x10
R25, R27: 1R/0.5W; R_0805_2012Metric
U4: CSD95472Q5MC; CSD95472-SON-5x6

Connections:
+5V: R25.1
+12V: C20.1, C23.1, C81.1, C89.1, C117.1, C118.1, U4.7 (VIN)
+VRef: C10.1, U4.2 (REFIN)
CSP: U4.1 (IOUT)
FCCM: U4.10 (FCCM)
GND: C10.2, C12.2, C18.2, C20.2, C21.2, C23.2, C24.2, C81.2, C86.2, C89.2, C90.2, C109.2, C117.2, C118.2, U4.4 (PGND), U4.13 (PGND)
unnamed: C12.1, R25.2, U4.3 (ENABLE), U4.5 (VDD)
unnamed: C14.1, U4.9 (BOOT)
unnamed: C14.2, U4.8 (BOOT_R)
unnamed: C18.1, R27.1
unnamed: L1.1, R27.2, U4.6 (VSW)
PWM: U4.12 (PWM)
TPS_TSEN: C109.1, U4.11 (TAO/FAULT)
VOUT: C21.1, C24.1, C86.1, C90.1, L1.2
