pacovalverde/nerdquaxe/firmware/embassy/embassy-hal-internal/src/interrupt.rs

//! Interrupt handling for cortex-m devices.
use core::mem;
use core::sync::atomic::{compiler_fence, Ordering};

use cortex_m::interrupt::InterruptNumber;
use cortex_m::peripheral::NVIC;
use critical_section::CriticalSection;

/// Generate a standard `mod interrupt` for a HAL.
#[macro_export]
macro_rules! interrupt_mod {
    ($($irqs:ident),* $(,)?) => {
        #[cfg(feature = "rt")]
        pub use cortex_m_rt::interrupt;

        /// Interrupt definitions.
        pub mod interrupt {
            pub use $crate::interrupt::{InterruptExt, Priority};
            pub use crate::pac::Interrupt::*;
            pub use crate::pac::Interrupt;

            /// Type-level interrupt infrastructure.
            ///
            /// This module contains one *type* per interrupt. This is used for checking at compile time that
            /// the interrupts are correctly bound to HAL drivers.
            ///
            /// As an end user, you shouldn't need to use this module directly. Use the [`crate::bind_interrupts!`] macro
            /// to bind interrupts, and the [`crate::interrupt`] module to manually register interrupt handlers and manipulate
            /// interrupts directly (pending/unpending, enabling/disabling, setting the priority, etc...)
            pub mod typelevel {
                use super::InterruptExt;

                trait SealedInterrupt {}

                /// Type-level interrupt.
                ///
                /// This trait is implemented for all typelevel interrupt types in this module.
                pub trait Interrupt: SealedInterrupt {

                    /// Interrupt enum variant.
                    ///
                    /// This allows going from typelevel interrupts (one type per interrupt) to
                    /// non-typelevel interrupts (a single `Interrupt` enum type, with one variant per interrupt).
                    const IRQ: super::Interrupt;

                    /// Enable the interrupt.
                    #[inline]
                    unsafe fn enable() {
                        Self::IRQ.enable()
                    }

                    /// Disable the interrupt.
                    #[inline]
                    fn disable() {
                        Self::IRQ.disable()
                    }

                    /// Check if interrupt is enabled.
                    #[inline]
                    fn is_enabled() -> bool {
                        Self::IRQ.is_enabled()
                    }

                    /// Check if interrupt is pending.
                    #[inline]
                    fn is_pending() -> bool {
                        Self::IRQ.is_pending()
                    }

                    /// Set interrupt pending.
                    #[inline]
                    fn pend() {
                        Self::IRQ.pend()
                    }

                    /// Unset interrupt pending.
                    #[inline]
                    fn unpend() {
                        Self::IRQ.unpend()
                    }

                    /// Get the priority of the interrupt.
                    #[inline]
                    fn get_priority() -> crate::interrupt::Priority {
                        Self::IRQ.get_priority()
                    }

                    /// Set the interrupt priority.
                    #[inline]
                    fn set_priority(prio: crate::interrupt::Priority) {
                        Self::IRQ.set_priority(prio)
                    }

                    /// Set the interrupt priority with an already-acquired critical section
                    #[inline]
                    fn set_priority_with_cs(cs: critical_section::CriticalSection, prio: crate::interrupt::Priority) {
                        Self::IRQ.set_priority_with_cs(cs, prio)
                    }
                }

                $(
                    #[allow(non_camel_case_types)]
                    #[doc=stringify!($irqs)]
                    #[doc=" typelevel interrupt."]
                    pub enum $irqs {}
                    impl SealedInterrupt for $irqs{}
                    impl Interrupt for $irqs {
                        const IRQ: super::Interrupt = super::Interrupt::$irqs;
                    }
                )*

                /// Interrupt handler trait.
                ///
                /// Drivers that need to handle interrupts implement this trait.
                /// The user must ensure `on_interrupt()` is called every time the interrupt fires.
                /// Drivers must use use [`Binding`] to assert at compile time that the user has done so.
                pub trait Handler<I: Interrupt> {
                    /// Interrupt handler function.
                    ///
                    /// Must be called every time the `I` interrupt fires, synchronously from
                    /// the interrupt handler context.
                    ///
                    /// # Safety
                    ///
                    /// This function must ONLY be called from the interrupt handler for `I`.
                    unsafe fn on_interrupt();
                }

                /// Compile-time assertion that an interrupt has been bound to a handler.
                ///
                /// For the vast majority of cases, you should use the `bind_interrupts!`
                /// macro instead of writing `unsafe impl`s of this trait.
                ///
                /// # Safety
                ///
                /// By implementing this trait, you are asserting that you have arranged for `H::on_interrupt()`
                /// to be called every time the `I` interrupt fires.
                ///
                /// This allows drivers to check bindings at compile-time.
                pub unsafe trait Binding<I: Interrupt, H: Handler<I>> {}
            }
        }
    };
}

/// Represents an interrupt type that can be configured by embassy to handle
/// interrupts.
pub unsafe trait InterruptExt: InterruptNumber + Copy {
    /// Enable the interrupt.
    #[inline]
    unsafe fn enable(self) {
        compiler_fence(Ordering::SeqCst);
        NVIC::unmask(self)
    }

    /// Disable the interrupt.
    #[inline]
    fn disable(self) {
        NVIC::mask(self);
        compiler_fence(Ordering::SeqCst);
    }

    /// Check if interrupt is being handled.
    #[inline]
    #[cfg(not(armv6m))]
    fn is_active(self) -> bool {
        NVIC::is_active(self)
    }

    /// Check if interrupt is enabled.
    #[inline]
    fn is_enabled(self) -> bool {
        NVIC::is_enabled(self)
    }

    /// Check if interrupt is pending.
    #[inline]
    fn is_pending(self) -> bool {
        NVIC::is_pending(self)
    }

    /// Set interrupt pending.
    #[inline]
    fn pend(self) {
        NVIC::pend(self)
    }

    /// Unset interrupt pending.
    #[inline]
    fn unpend(self) {
        NVIC::unpend(self)
    }

    /// Get the priority of the interrupt.
    #[inline]
    fn get_priority(self) -> Priority {
        Priority::from(NVIC::get_priority(self))
    }

    /// Set the interrupt priority.
    #[inline]
    fn set_priority(self, prio: Priority) {
        unsafe {
            let mut nvic: cortex_m::peripheral::NVIC = mem::transmute(());

            // On thumbv6, set_priority must do a RMW to change 8bit in a 32bit reg.
            #[cfg(armv6m)]
            critical_section::with(|_| nvic.set_priority(self, prio.into()));
            // On thumbv7+, set_priority does an atomic 8bit write, so no CS needed.
            #[cfg(not(armv6m))]
            nvic.set_priority(self, prio.into());
        }
    }

    /// Set the interrupt priority with an already-acquired critical section
    ///
    /// Equivalent to `set_priority`, except you pass a `CriticalSection` to prove
    /// you've already acquired a critical section. This prevents acquiring another
    /// one, which saves code size.
    #[inline]
    fn set_priority_with_cs(self, _cs: CriticalSection, prio: Priority) {
        unsafe {
            let mut nvic: cortex_m::peripheral::NVIC = mem::transmute(());
            nvic.set_priority(self, prio.into());
        }
    }
}

unsafe impl<T: InterruptNumber + Copy> InterruptExt for T {}

impl From<u8> for Priority {
    fn from(priority: u8) -> Self {
        unsafe { mem::transmute(priority & PRIO_MASK) }
    }
}

impl From<Priority> for u8 {
    fn from(p: Priority) -> Self {
        p as u8
    }
}

#[cfg(feature = "prio-bits-0")]
const PRIO_MASK: u8 = 0x00;
#[cfg(feature = "prio-bits-1")]
const PRIO_MASK: u8 = 0x80;
#[cfg(feature = "prio-bits-2")]
const PRIO_MASK: u8 = 0xc0;
#[cfg(feature = "prio-bits-3")]
const PRIO_MASK: u8 = 0xe0;
#[cfg(feature = "prio-bits-4")]
const PRIO_MASK: u8 = 0xf0;
#[cfg(feature = "prio-bits-5")]
const PRIO_MASK: u8 = 0xf8;
#[cfg(feature = "prio-bits-6")]
const PRIO_MASK: u8 = 0xfc;
#[cfg(feature = "prio-bits-7")]
const PRIO_MASK: u8 = 0xfe;
#[cfg(feature = "prio-bits-8")]
const PRIO_MASK: u8 = 0xff;

/// The interrupt priority level.
///
/// NOTE: The contents of this enum differ according to the set `prio-bits-*` Cargo feature.
#[cfg(feature = "prio-bits-0")]
#[derive(Debug, Copy, Clone, Eq, PartialEq, Ord, PartialOrd)]
#[cfg_attr(feature = "defmt", derive(defmt::Format))]
#[repr(u8)]
#[allow(missing_docs)]
pub enum Priority {
    P0 = 0x0,
}

/// The interrupt priority level.
///
/// NOTE: The contents of this enum differ according to the set `prio-bits-*` Cargo feature.
#[cfg(feature = "prio-bits-1")]
#[derive(Debug, Copy, Clone, Eq, PartialEq, Ord, PartialOrd)]
#[cfg_attr(feature = "defmt", derive(defmt::Format))]
#[repr(u8)]
#[allow(missing_docs)]
pub enum Priority {
    P0 = 0x0,
    P1 = 0x80,
}

/// The interrupt priority level.
///
/// NOTE: The contents of this enum differ according to the set `prio-bits-*` Cargo feature.
#[cfg(feature = "prio-bits-2")]
#[derive(Debug, Copy, Clone, Eq, PartialEq, Ord, PartialOrd)]
#[cfg_attr(feature = "defmt", derive(defmt::Format))]
#[repr(u8)]
#[allow(missing_docs)]
pub enum Priority {
    P0 = 0x0,
    P1 = 0x40,
    P2 = 0x80,
    P3 = 0xc0,
}

/// The interrupt priority level.
///
/// NOTE: The contents of this enum differ according to the set `prio-bits-*` Cargo feature.
#[cfg(feature = "prio-bits-3")]
#[derive(Debug, Copy, Clone, Eq, PartialEq, Ord, PartialOrd)]
#[cfg_attr(feature = "defmt", derive(defmt::Format))]
#[repr(u8)]
#[allow(missing_docs)]
pub enum Priority {
    P0 = 0x0,
    P1 = 0x20,
    P2 = 0x40,
    P3 = 0x60,
    P4 = 0x80,
    P5 = 0xa0,
    P6 = 0xc0,
    P7 = 0xe0,
}

/// The interrupt priority level.
///
/// NOTE: The contents of this enum differ according to the set `prio-bits-*` Cargo feature.
#[cfg(feature = "prio-bits-4")]
#[derive(Debug, Copy, Clone, Eq, PartialEq, Ord, PartialOrd)]
#[cfg_attr(feature = "defmt", derive(defmt::Format))]
#[repr(u8)]
#[allow(missing_docs)]
pub enum Priority {
    P0 = 0x0,
    P1 = 0x10,
    P2 = 0x20,
    P3 = 0x30,
    P4 = 0x40,
    P5 = 0x50,
    P6 = 0x60,
    P7 = 0x70,
    P8 = 0x80,
    P9 = 0x90,
    P10 = 0xa0,
    P11 = 0xb0,
    P12 = 0xc0,
    P13 = 0xd0,
    P14 = 0xe0,
    P15 = 0xf0,
}

/// The interrupt priority level.
///
/// NOTE: The contents of this enum differ according to the set `prio-bits-*` Cargo feature.
#[cfg(feature = "prio-bits-5")]
#[derive(Debug, Copy, Clone, Eq, PartialEq, Ord, PartialOrd)]
#[cfg_attr(feature = "defmt", derive(defmt::Format))]
#[repr(u8)]
#[allow(missing_docs)]
pub enum Priority {
    P0 = 0x0,
    P1 = 0x8,
    P2 = 0x10,
    P3 = 0x18,
    P4 = 0x20,
    P5 = 0x28,
    P6 = 0x30,
    P7 = 0x38,
    P8 = 0x40,
    P9 = 0x48,
    P10 = 0x50,
    P11 = 0x58,
    P12 = 0x60,
    P13 = 0x68,
    P14 = 0x70,
    P15 = 0x78,
    P16 = 0x80,
    P17 = 0x88,
    P18 = 0x90,
    P19 = 0x98,
    P20 = 0xa0,
    P21 = 0xa8,
    P22 = 0xb0,
    P23 = 0xb8,
    P24 = 0xc0,
    P25 = 0xc8,
    P26 = 0xd0,
    P27 = 0xd8,
    P28 = 0xe0,
    P29 = 0xe8,
    P30 = 0xf0,
    P31 = 0xf8,
}

/// The interrupt priority level.
///
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
    P22 = 0x16,
    P23 = 0x17,
    P24 = 0x18,
    P25 = 0x19,
    P26 = 0x1a,
    P27 = 0x1b,
    P28 = 0x1c,
    P29 = 0x1d,
    P30 = 0x1e,
    P31 = 0x1f,
    P32 = 0x20,
    P33 = 0x21,
    P34 = 0x22,
    P35 = 0x23,
    P36 = 0x24,
    P37 = 0x25,
    P38 = 0x26,
    P39 = 0x27,
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
}
