pacovalverde/nerdquaxe/(commit log)

2025-05-31 (PV 31.05.2025) First commit
    [DCJ250-20-B-XX-X_REVA1.step, FP1006V2-R.STEP, KMR231GLFS.stp, Littelfuse 0154.500DRT without value_black v2.step, T-Display-S3.STEP, back.stl, barrel-jack.step, bm1366.kicad_sch]
2025-06-01 (PV 01.06.2025) Modificación de .gitignore y agrego archivos *.csv
    [digikey.csv, digikey_with_refs.csv]
2025-06-01 (PV 01.06.2025) Agregados archivos comprimidos .zip de backups
2025-06-01 (PV 01.06.2025) Modificación de .gitignore
